mkhrenov/openhell/openhell-pcb/symbols-and-footprints/bnyah_knife.png

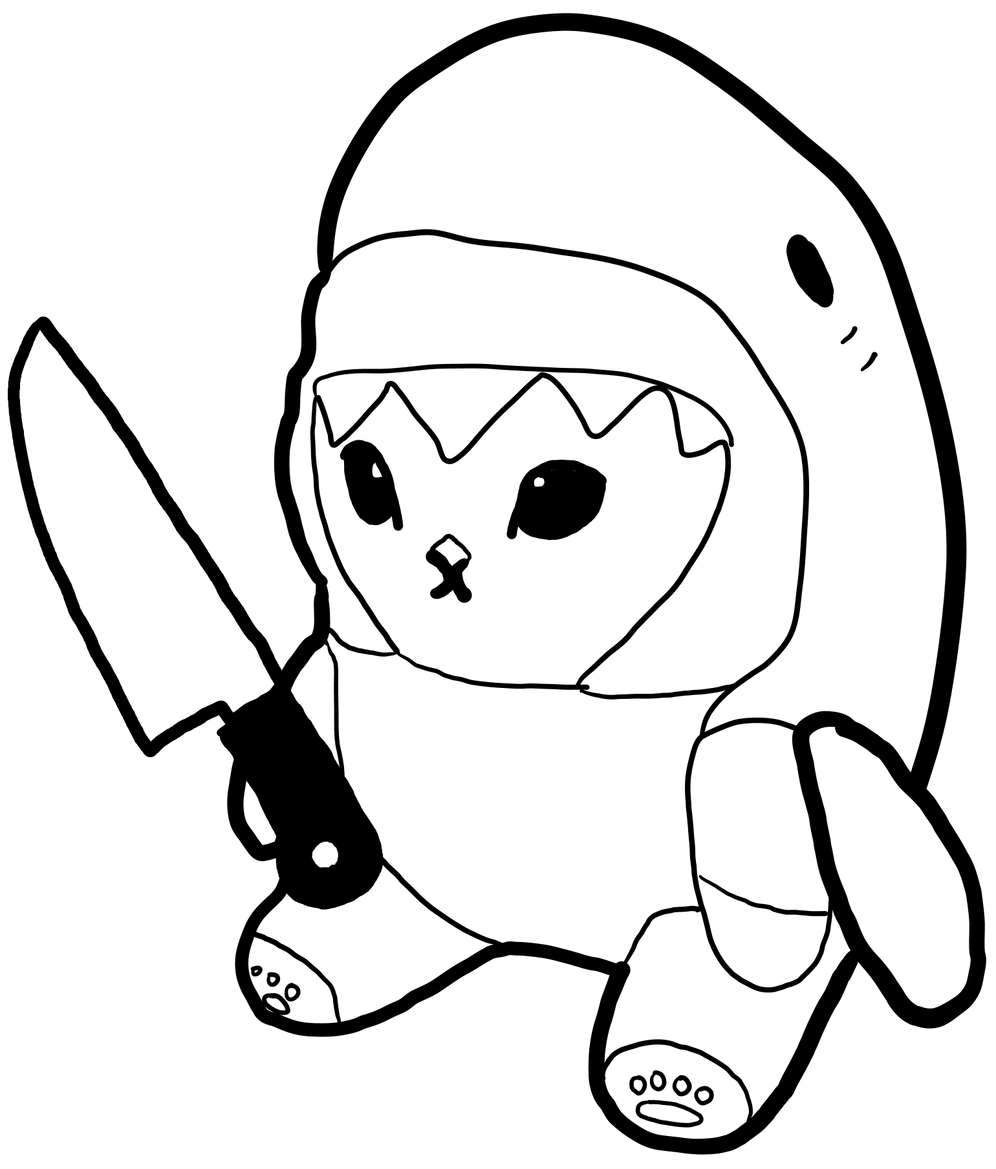
openhell-pcb/symbols-and-footprints/bnyah_knife.png
