mkhrenov/openhell/openhell-pcb/symbols-and-footprints/bnyah_peek.png

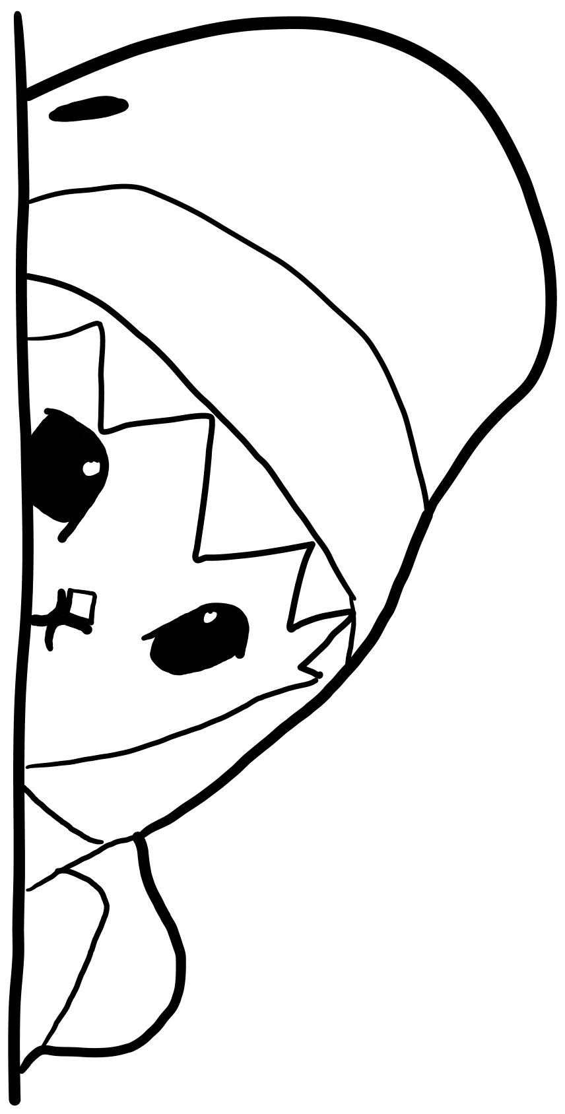
openhell-pcb/symbols-and-footprints/bnyah_peek.png
