mkhrenov/openhell/openhell-pcb/symbols-and-footprints/bnyahaj.png

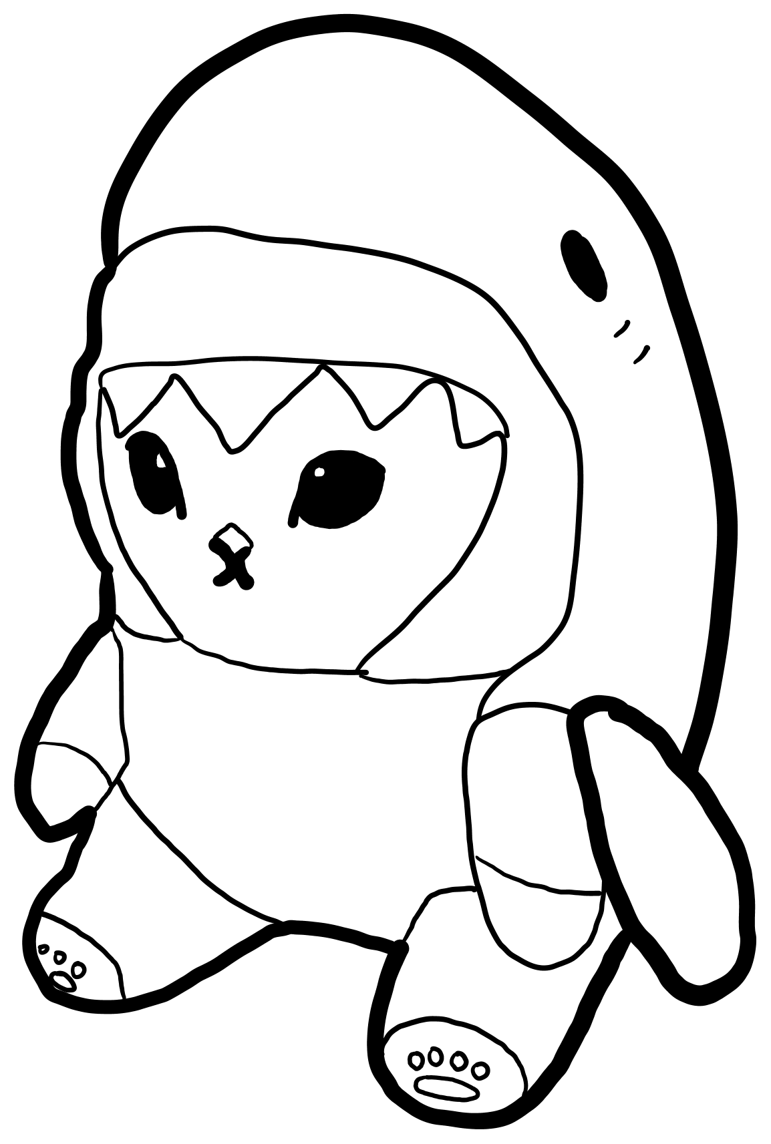
openhell-pcb/symbols-and-footprints/bnyahaj.png
