mkhrenov/openhell/openhell-pcb/symbols-and-footprints/bnyarson.png

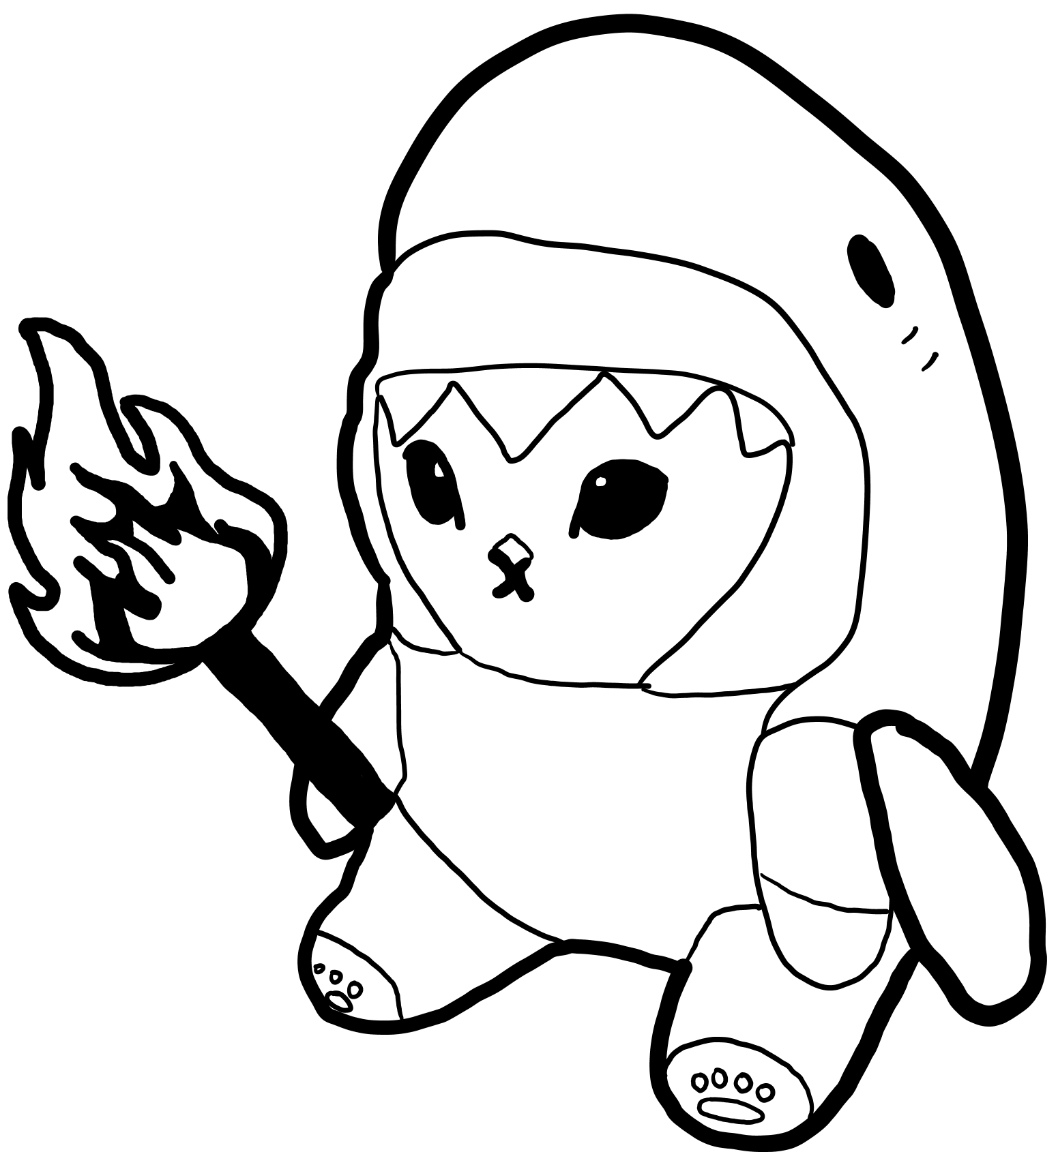
openhell-pcb/symbols-and-footprints/bnyarson.png
