mkhrenov/openhell/openhell-pcb/symbols-and-footprints/bnyarson_flipped.png

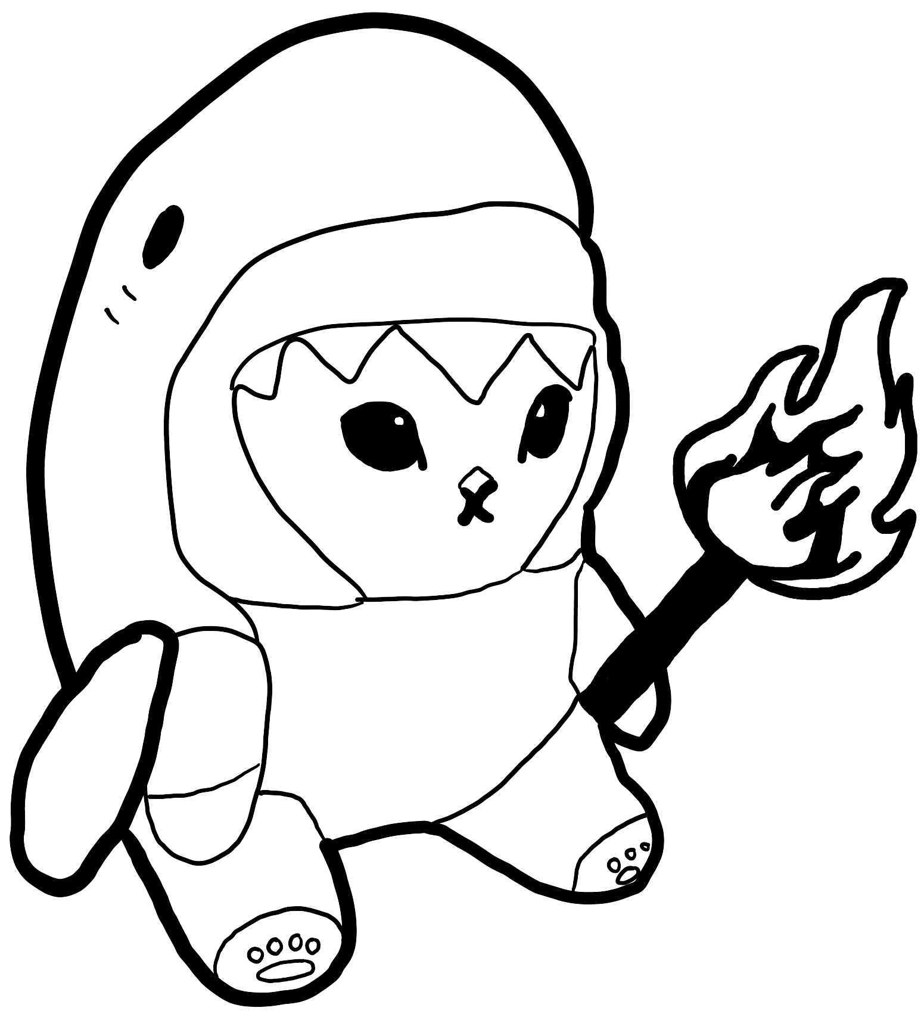
openhell-pcb/symbols-and-footprints/bnyarson_flipped.png
