mkhrenov/openhell/openhell-pcb/symbols-and-footprints/pittsburgh.jpg

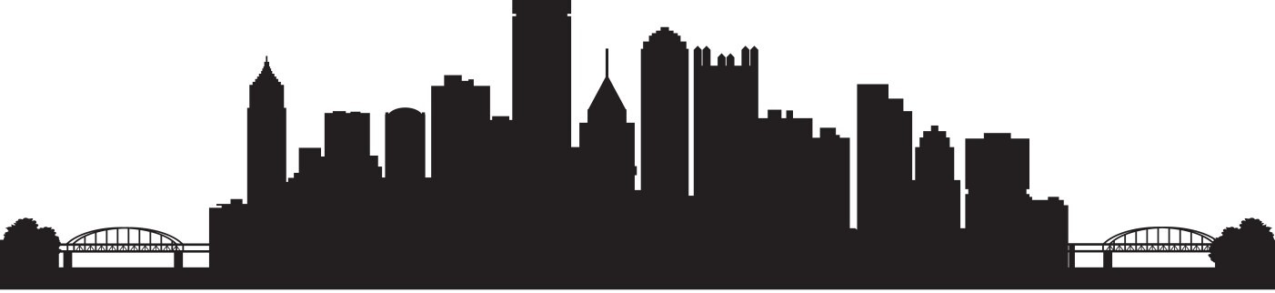
openhell-pcb/symbols-and-footprints/pittsburgh.jpg
