mkhrenov/openhell/openhell-pcb/symbols-and-footprints/steel_mill.png

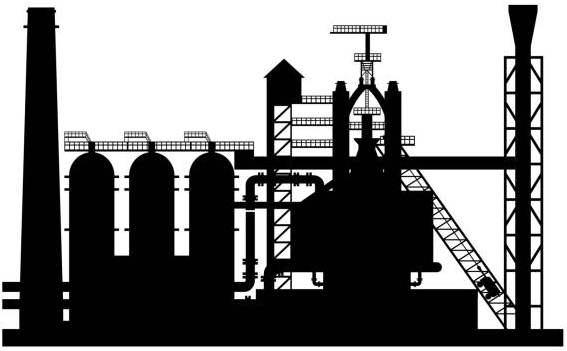
openhell-pcb/symbols-and-footprints/steel_mill.png
