mkhrenov/openhell/openhell-pcb/Mouser-BOM.xls

SHOPPING CART
This is not an invoice
10-Mar-25 10:58:04
 | Mouser # | Mfr. # | Manufacturer | Customer # | Description | RoHS | Lifecycle | Order Qty. | Price (USD) | Ext.: (USD)
1 | 511-LSM6DSRTR | LSM6DSRTR | STMicroelectronics |  | IMUs - Inertial Measurement Units iNEMO Inertial Module: 3D Accelerometer and 3D Gyroscope | RoHS Compliant |  | 1 | $3.58 | $3.58
2 | 55-IF145-060-3 | IF145-060-3 | iFixit |  | Pliers & Tweezers Precision Tweezer Set | Not Applicable | New Product | 1 | $9.95 | $9.95
3 | 621-AP63205WU-7 | AP63205WU-7 | Diodes Incorporated |  | Switching Voltage Regulators DCDC Conv HV Buck TSOT26 T&R 3K | RoHS Compliant |  | 1 | $1.38 | $1.38
4 | 511-H3LIS331DLTR | H3LIS331DLTR | STMicroelectronics |  | Accelerometers Low Pwr Hi G 3-axis Digital Acceleromtr | RoHS Compliant By Exemption |  | 1 | $9.76 | $9.76
5 | 710-691137710002 | 691137710002 | Wurth Elektronik | Screw Terminals | Barrier Terminal Blocks WR-TBL 300VAC 16A 2P Right Angle | RoHS Compliant |  | 1 | $0.41 | $0.41
6 | 187-CL21A106KOQNNNG | CL21A106KOQNNNG | Samsung Electro-Mechanics | C8 | Multilayer Ceramic Capacitors MLCC - SMD/SMT 10uF+/-10% 16V X5R 2 0805 | RoHS Compliant |  | 1 | $0.10 | $0.10
7 | 187-CL05B104KP5NNNC | CL05B104KP5NNNC | Samsung Electro-Mechanics | C5, C6, C7 | Multilayer Ceramic Capacitors MLCC - SMD/SMT 100nF+/-10% 10V X7R 0402 | RoHS Compliant |  | 3 | $0.10 | $0.30
8 | 187-CL10A226MP8NUNE | CL10A226MP8NUNE | Samsung Electro-Mechanics | C3, C4 | Multilayer Ceramic Capacitors MLCC - SMD/SMT 22uF+/-20% 10V X5R 1 0603 | RoHS Compliant |  | 2 | $0.13 | $0.26
9 | 81-GRM188R6YA106MA3D | GRM188R6YA106MA73D | Murata | C1 | Multilayer Ceramic Capacitors MLCC - SMD/SMT 10 uF 35 VDC 20% 0603 X5R | RoHS Compliant |  | 1 | $0.30 | $0.30
10 | 815-ASPI-4030S-4R7MT | ASPI-4030S-4R7M-T | ABRACON | L1 | Power Inductors - SMD 4.7 UH 20% | RoHS Compliant By Exemption |  | 1 | $0.29 | $0.29
11 | 81-GRM33R6YA104KE14D | GRM033R6YA104KE14D | Murata | C2 | Multilayer Ceramic Capacitors MLCC - SMD/SMT 0.1 uF 35 VDC 10% 0201 X5R | RoHS Compliant |  | 1 | $0.13 | $0.13
12 | 200-TSW10608TTRA | TSW-106-08-T-T-RA | Samtec | GPIO Headers | Headers & Wire Housings Classic PCB Header Strips, 0.100" pitch | RoHS Compliant |  | 1 | $1.34 | $1.34
By submitting your order you agree to these terms and conditions. (https://www.mouser.com/saleterms) |  |  |  |  |  |  |  |  | Merchandise: | $27.80
Prices are reflected at the date and time shown. |  |  |  |  |  |  |  |  | Shipping Charge: | $4.99
