mkhrenov/openhell/openhell-pcb/Pinout.xlsx

Arduino Pin Label | GPIO Number | Connection
D2 | 5 | RP2 RX (Arduino TX)
D3 | 6 | RP2 TX (Arduino RX)
D13 | 16 | SPI SCK
D12 | 47 | SPI CIPO
D11 | 38 | SPI COPI
D10 | 21 | SPI CS0 (LSM6DSRTR)
D9 | 18 | SPI CS1 (H3LIS331DLTR)
