mkhrenov/openhell/0000 - OPENHELL CAD/1000 - STRUCTURE/P-1005-F - TOP WEAPON LOCK V2.SLDPRT

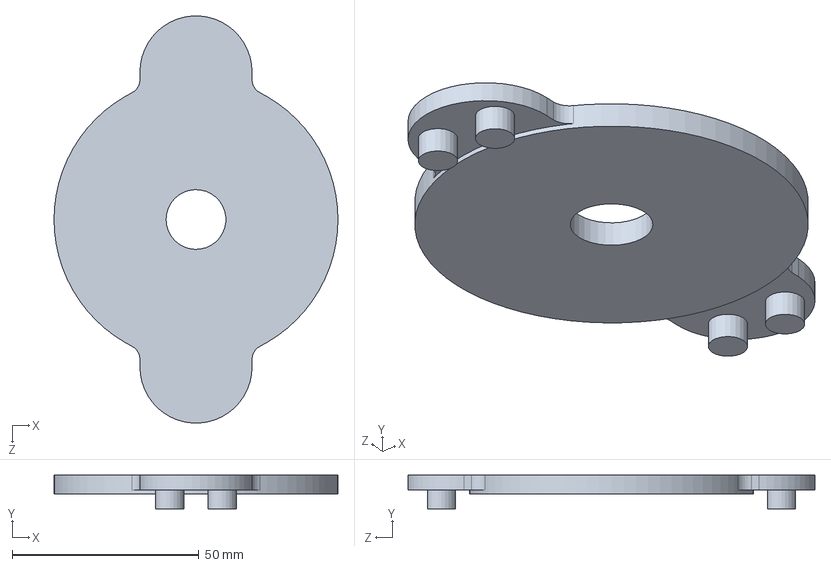
[picture p8: CAD file, 2025-04-30]
0000 - OPENHELL CAD/1000 - STRUCTURE/P-1005-F - TOP WEAPON LOCK V2.SLDPRT
76.0 x 9.00 x 108.9 mm
