mkhrenov/openhell/0000 - OPENHELL CAD/3000 - ELECTRONICS/P-3003-P - XT60E-F PLUG.SLDPRT

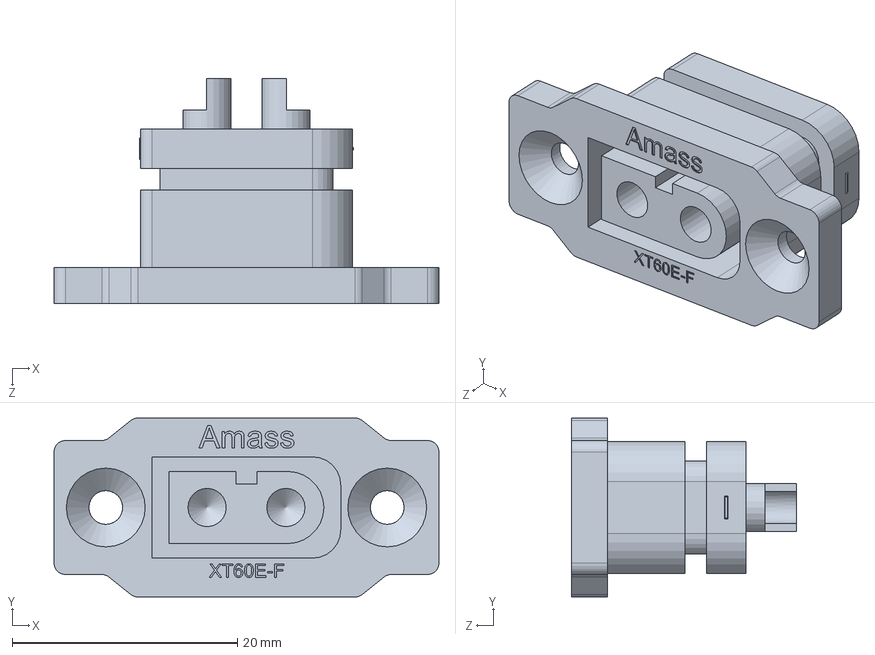
[picture p9: CAD file, 2025-04-19]
0000 - OPENHELL CAD/3000 - ELECTRONICS/P-3003-P - XT60E-F PLUG.SLDPRT
34.2 x 15.9 x 20.0 mm
