mkhrenov/openhell/0000 - OPENHELL CAD/4000 - INSTRUMENTATION/EDF LOAD CELL MOUNT.SLDPRT

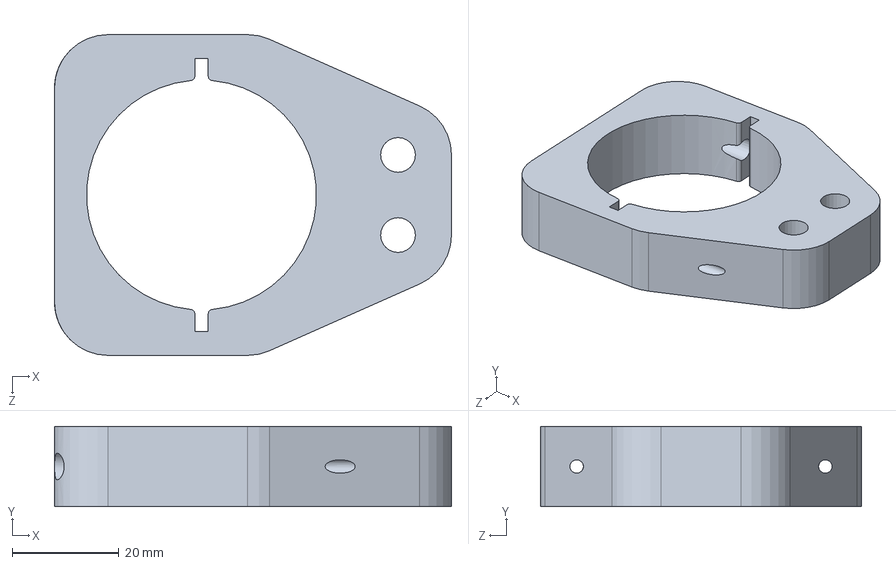
[picture p10: CAD file, 2025-04-08]
0000 - OPENHELL CAD/4000 - INSTRUMENTATION/EDF LOAD CELL MOUNT.SLDPRT
74.2 x 15.0 x 60.0 mm
