mkhrenov/openhell/3d print/P-1006-F - SERVICE CAP.STEP

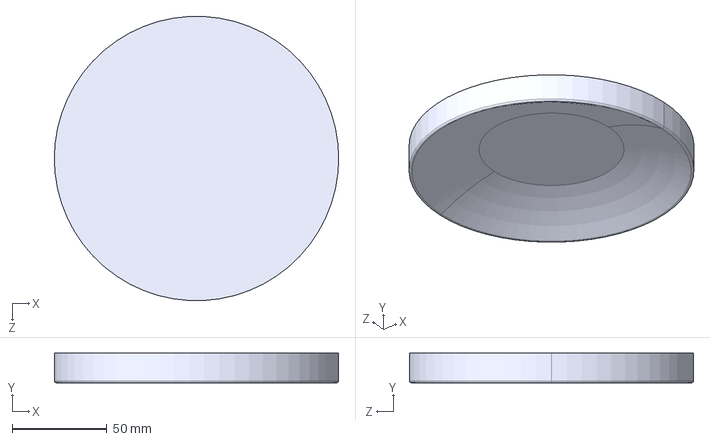
[picture p11: CAD file, 2025-04-30]
3d print/P-1006-F - SERVICE CAP.STEP
150.3 x 15.6 x 150.1 mm
