mkhrenov/openhell/openhell-pcb/combat-pcb.step

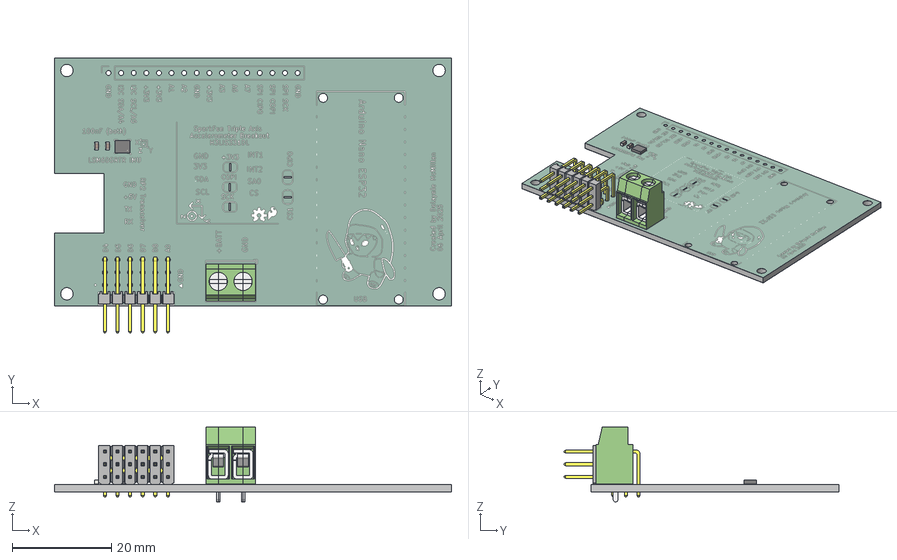
[picture p12: CAD file, 2025-05-05]
openhell-pcb/combat-pcb.step
80.0 x 55.4 x 15.1 mm
LGA-14_3x2.5mm_P0.5mm_LayoutBorder3x4y
TSW-106-08-T-T-RA_body
T-1S6-08-TSW-1-08-6-RA-T
MRT12P5_SX
MRT12P5_CNT
MRT12P5_DX
C_0603_1608Metric x 2
combat-pcb_silkscreen
combat-pcb_soldermask
combat-pcb_PCB
