mkhrenov/openhell/0000 - OPENHELL CAD/1000 - STRUCTURE/P-1004-P - HAT V2.SLDPRT

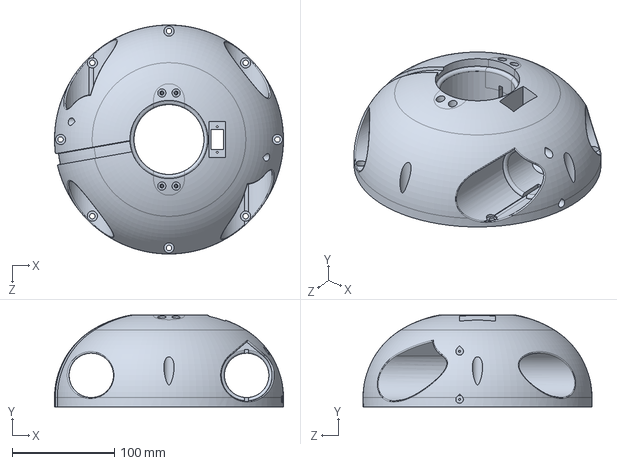
[picture p13: CAD file, 2025-04-30]
0000 - OPENHELL CAD/1000 - STRUCTURE/P-1004-P - HAT V2.SLDPRT
224.0 x 89.5 x 224.0 mm
