mkhrenov/openhell/0000 - OPENHELL CAD/2000 - FASTENERS/P-2001-P - M5 FLANGED LOCKNUT 92461A200.SLDPRT

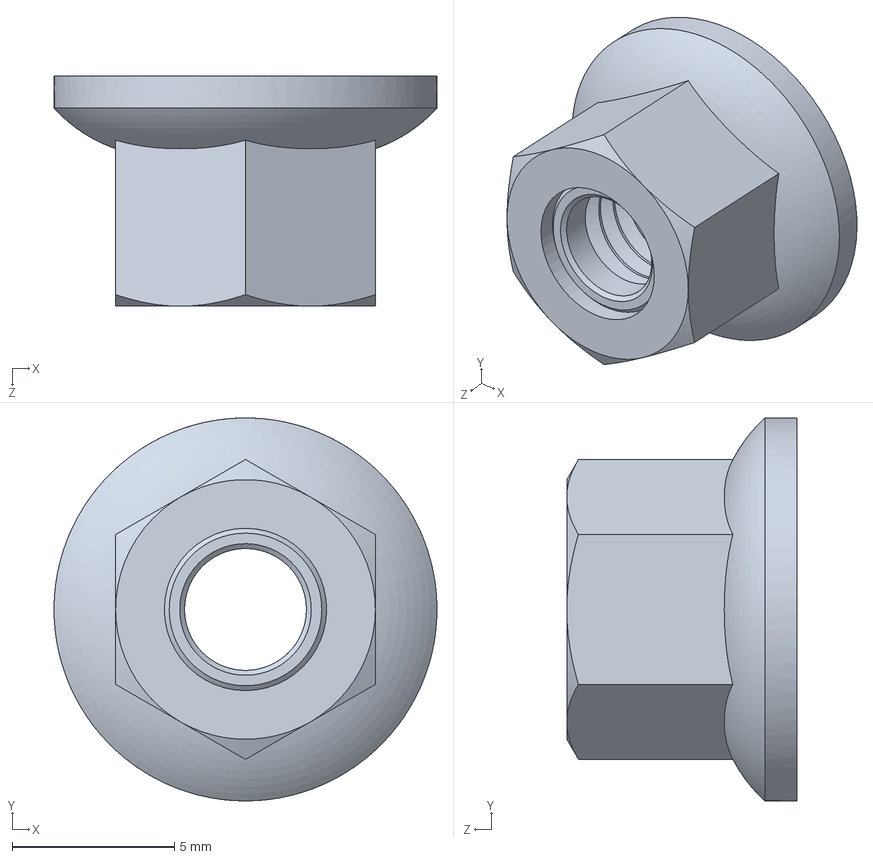
[picture p14: CAD file, 2025-04-19]
0000 - OPENHELL CAD/2000 - FASTENERS/P-2001-P - M5 FLANGED LOCKNUT 92461A200.SLDPRT
11.8 x 11.8 x 7.10 mm
