mkhrenov/openhell/3d print/P-1003-P - BRIM.STEP

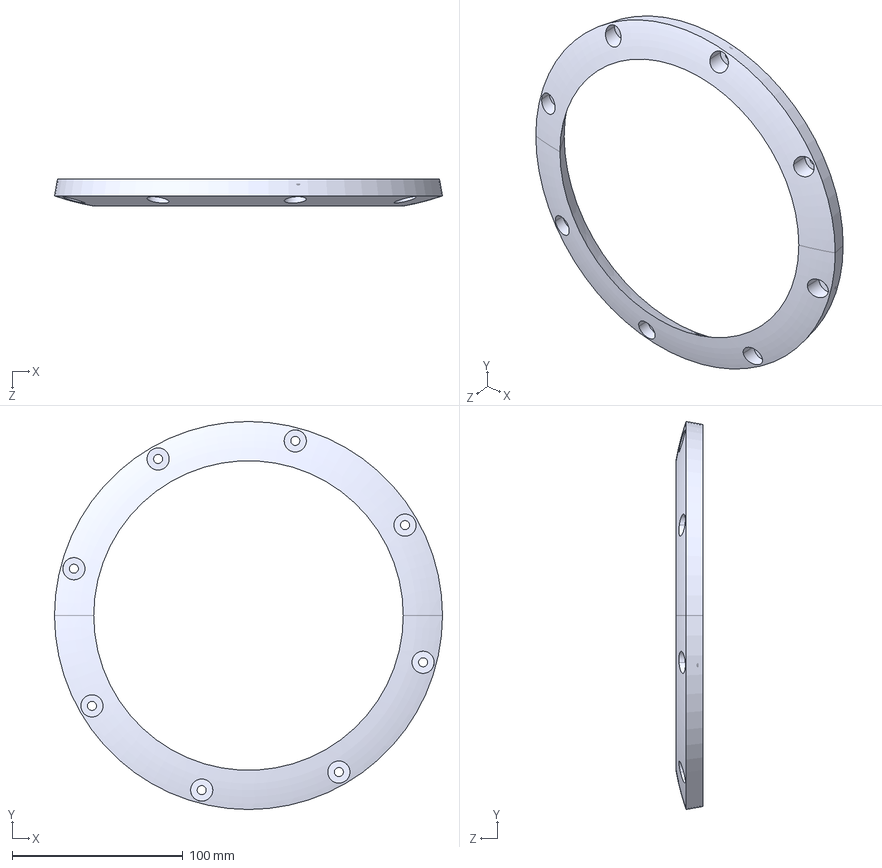
[picture p15: CAD file, 2025-04-08]
3d print/P-1003-P - BRIM.STEP
227.5 x 227.5 x 16.0 mm
