mkhrenov/openhell/0000 - OPENHELL CAD/1000 - STRUCTURE/S-1005-F - TOP WEAPON LOCK.3MF

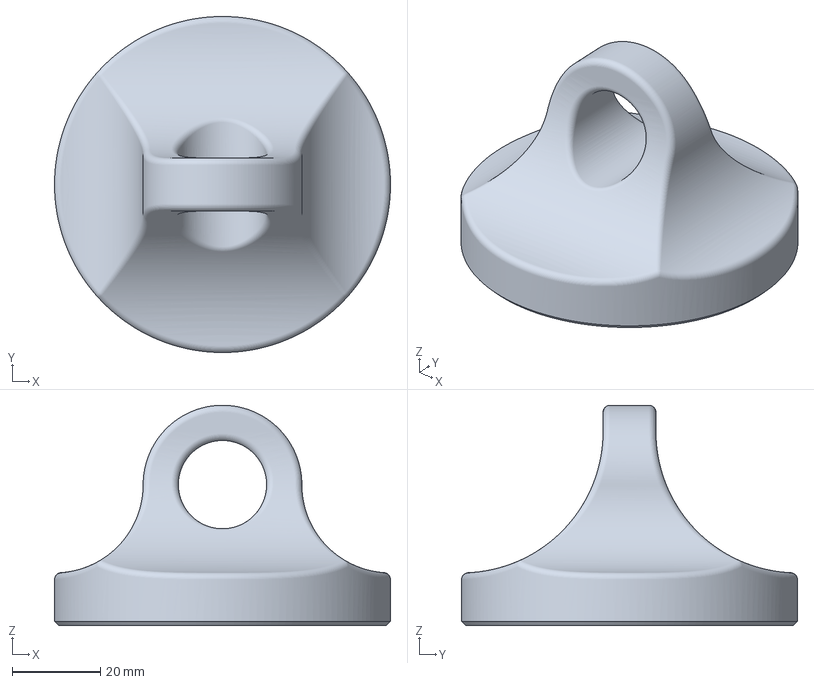
[picture p16: CAD file, 2025-04-19]
0000 - OPENHELL CAD/1000 - STRUCTURE/S-1005-F - TOP WEAPON LOCK.3MF
76.2 x 76.2 x 50.0 mm
