mkhrenov/openhell/3d print/P-1001-M - PLATE.DXF

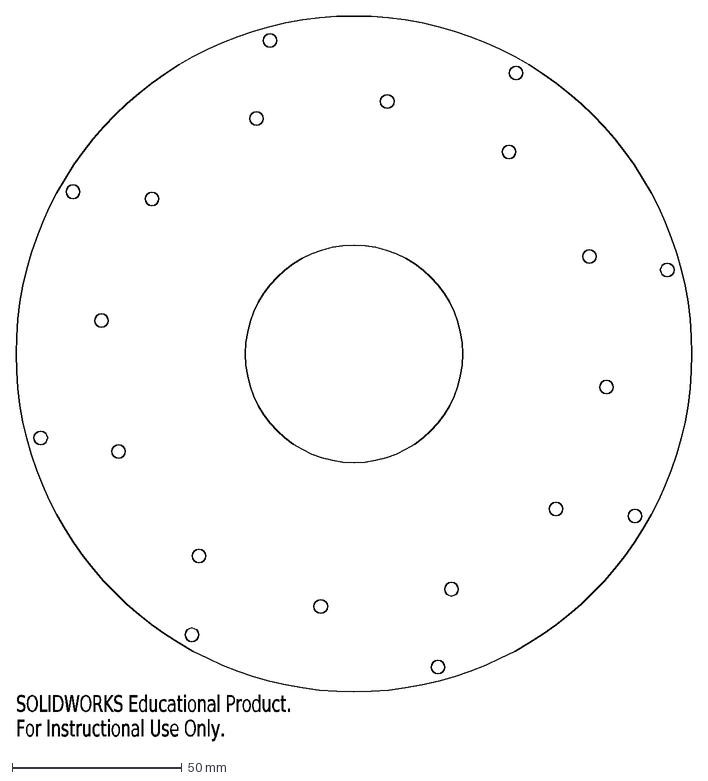
[picture p17: CAD file, 2025-04-08]
3d print/P-1001-M - PLATE.DXF
SOLIDWORKS Educational Product.
For Instructional Use Only.
