mkhrenov/openhell/0000 - OPENHELL CAD/1000 - STRUCTURE/P-1001-M - PLATE.SLDPRT

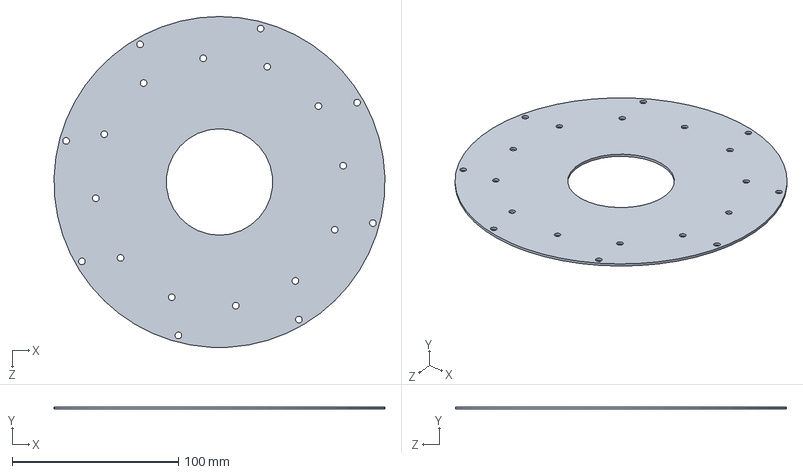
[picture p18: CAD file, 2025-04-19]
0000 - OPENHELL CAD/1000 - STRUCTURE/P-1001-M - PLATE.SLDPRT
198.9 x 1.50 x 199.0 mm
