mkhrenov/openhell/3d print/P-1005-P - SPREADER.STEP

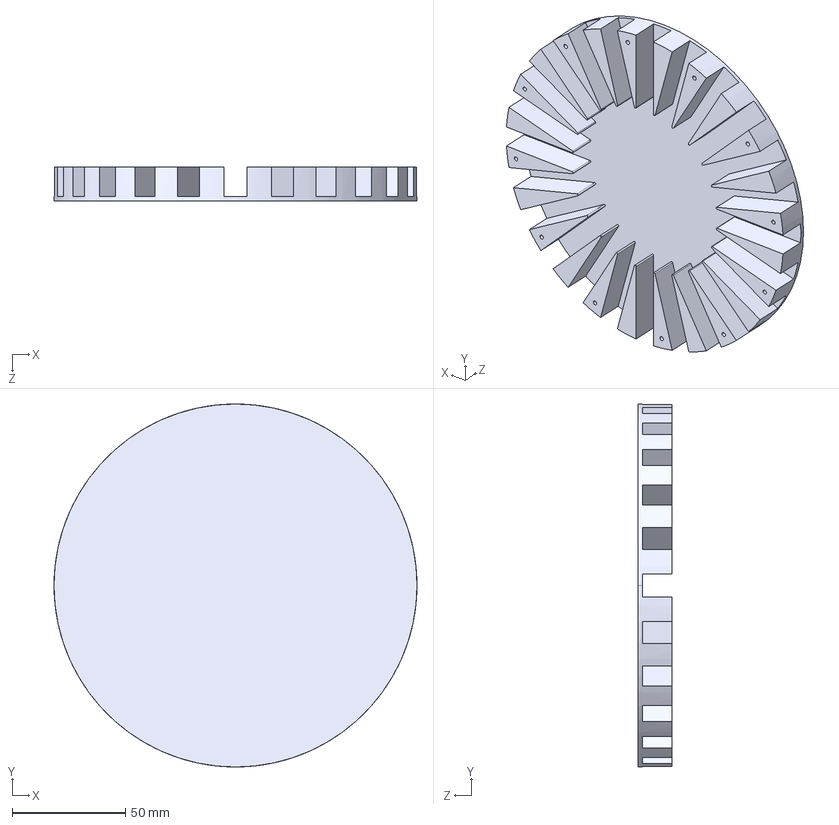
[picture p19: CAD file, 2025-04-08]
3d print/P-1005-P - SPREADER.STEP
160.0 x 160.0 x 15.0 mm
