mkhrenov/openhell/0000 - OPENHELL CAD/3000 - ELECTRONICS/P-3002-P - 4S 2000 mAh BATTERY.SLDPRT

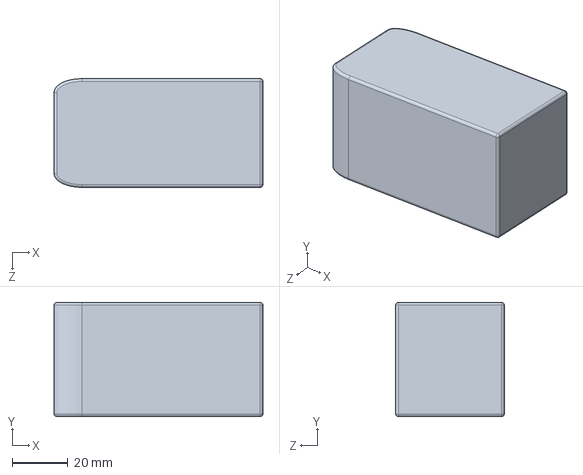
[picture p20: CAD file, 2025-04-19]
0000 - OPENHELL CAD/3000 - ELECTRONICS/P-3002-P - 4S 2000 mAh BATTERY.SLDPRT
75.0 x 41.0 x 39.0 mm
