mkhrenov/openhell/0000 - OPENHELL CAD/1000 - STRUCTURE/S-1004-F - SIDE WEAPON LOCK.3MF

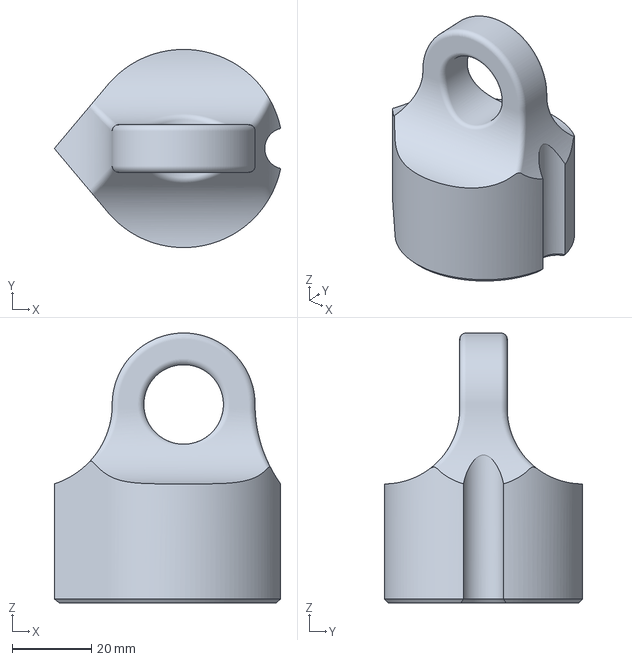
[picture p21: CAD file, 2025-04-19]
0000 - OPENHELL CAD/1000 - STRUCTURE/S-1004-F - SIDE WEAPON LOCK.3MF
57.0 x 49.9 x 68.0 mm
