mkhrenov/openhell/0000 - OPENHELL CAD/3000 - ELECTRONICS/P-3004-P - 45A ESC.SLDPRT

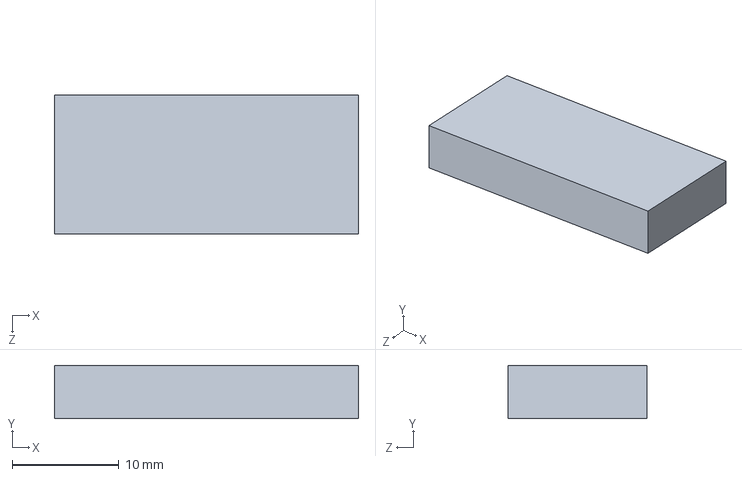
[picture p22: CAD file, 2025-04-19]
0000 - OPENHELL CAD/3000 - ELECTRONICS/P-3004-P - 45A ESC.SLDPRT
28.5 x 5.00 x 13.0 mm
