mkhrenov/openhell/0000 - OPENHELL CAD/3000 - ELECTRONICS/P-3001-P - EDF.SLDPRT

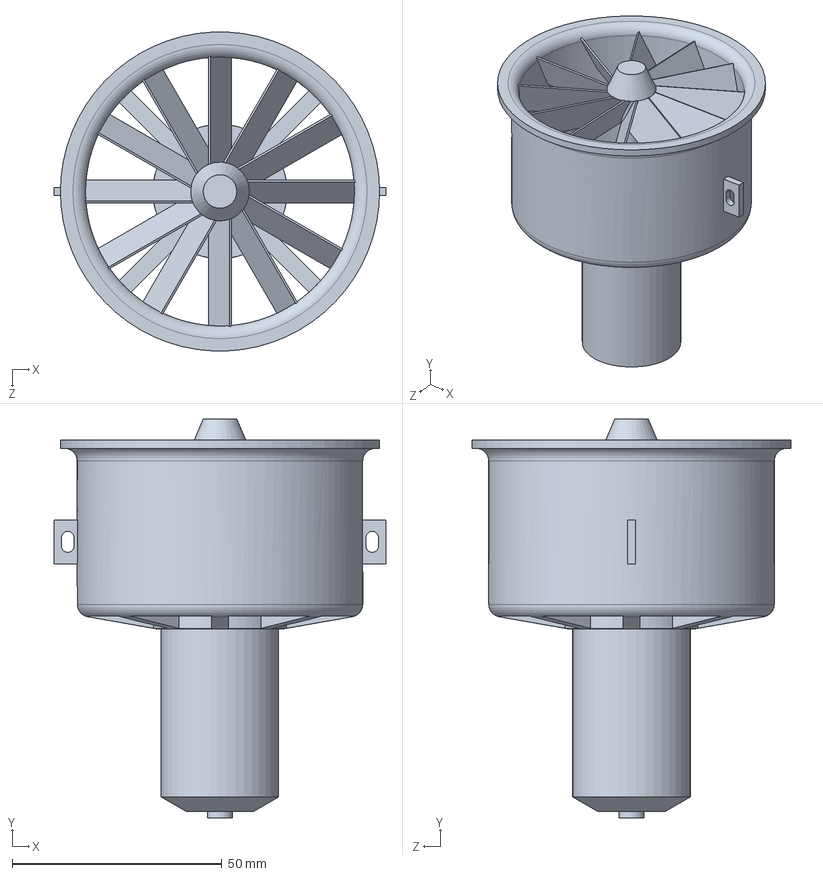
[picture p23: CAD file, 2025-04-19]
0000 - OPENHELL CAD/3000 - ELECTRONICS/P-3001-P - EDF.SLDPRT
79.0 x 95.0 x 75.9 mm
