mkhrenov/openhell/0000 - OPENHELL CAD/1000 - STRUCTURE/P-1002-P - BLADE.SLDPRT

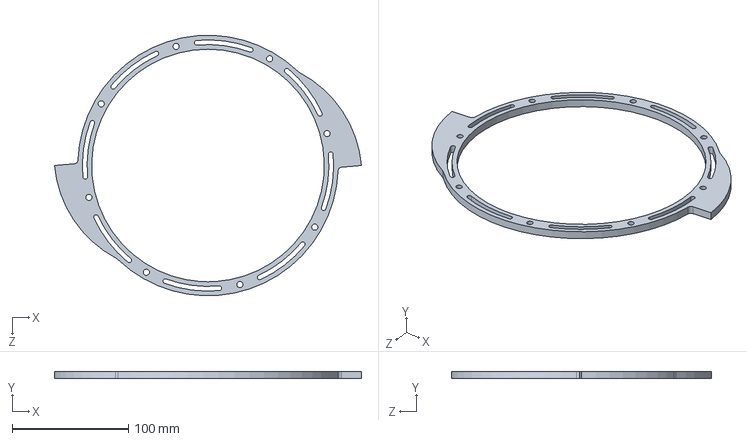
[picture p24: CAD file, 2025-04-19]
0000 - OPENHELL CAD/1000 - STRUCTURE/P-1002-P - BLADE.SLDPRT
264.0 x 6.35 x 223.8 mm
