mkhrenov/openhell/0000 - OPENHELL CAD/3000 - ELECTRONICS/P-3005-P - PROTOBOARD.SLDPRT

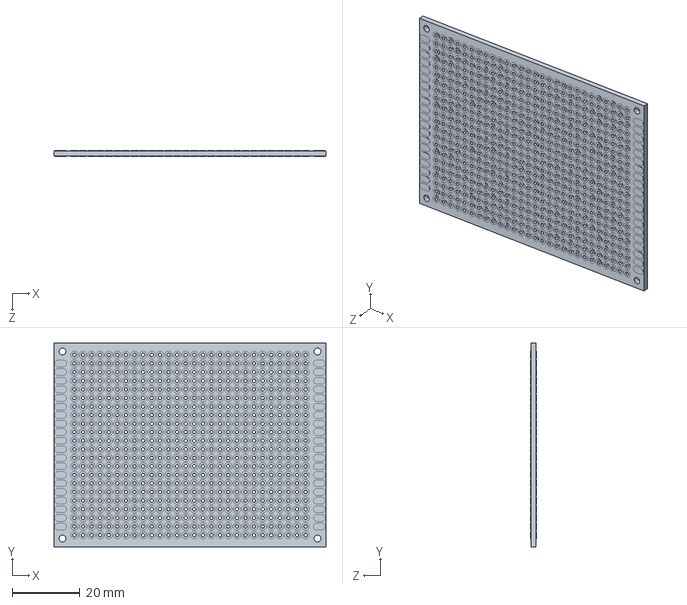
[picture p25: CAD file, 2025-04-08]
0000 - OPENHELL CAD/3000 - ELECTRONICS/P-3005-P - PROTOBOARD.SLDPRT
80.0 x 60.0 x 1.70 mm
