mkhrenov/openhell/0000 - OPENHELL CAD/1000 - STRUCTURE/D-1002-P - BLADE.DXF

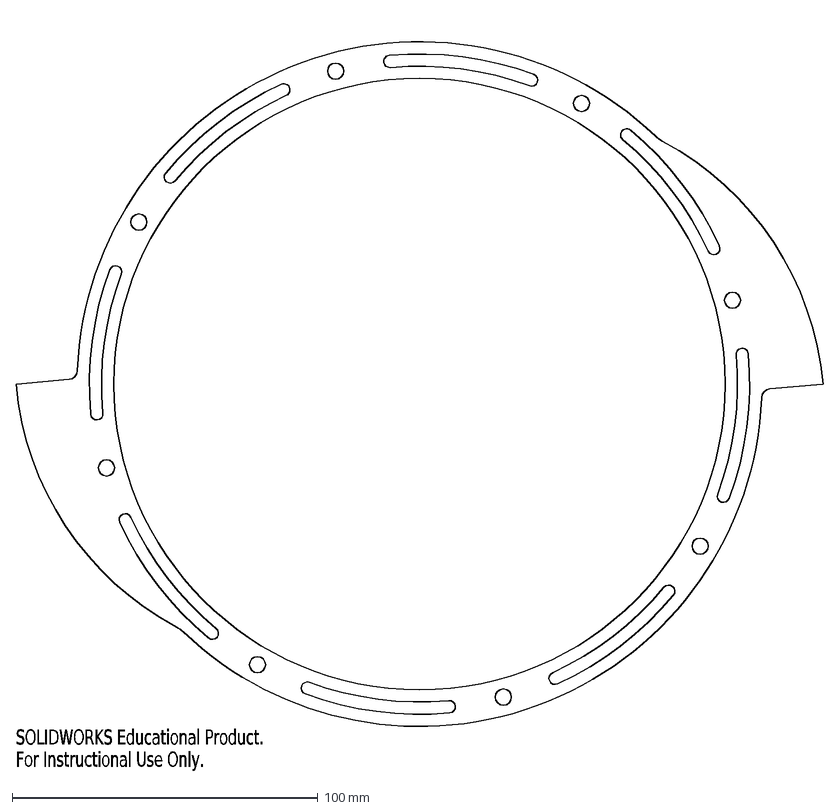
[picture p26: CAD file, 2025-04-08]
0000 - OPENHELL CAD/1000 - STRUCTURE/D-1002-P - BLADE.DXF
SOLIDWORKS Educational Product.
For Instructional Use Only.
