mkhrenov/openhell/0000 - OPENHELL CAD/1000 - STRUCTURE/S-1005-P - SPREADER.3MF

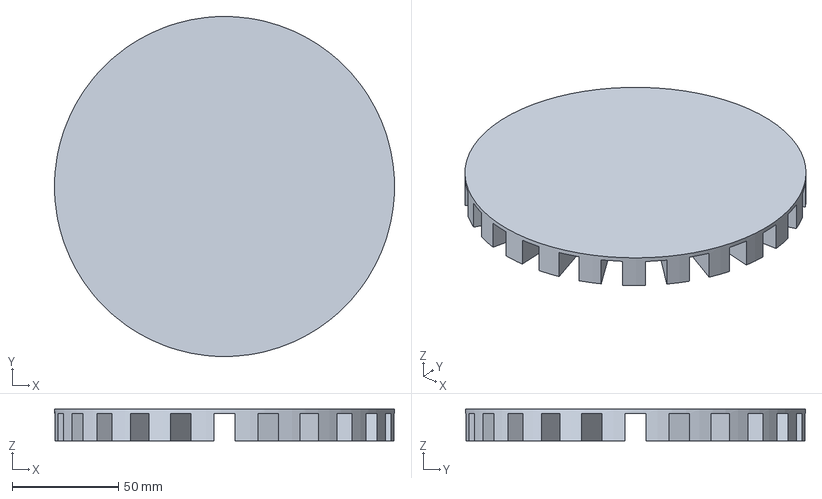
[picture p27: CAD file, 2025-03-09]
0000 - OPENHELL CAD/1000 - STRUCTURE/S-1005-P - SPREADER.3MF
160.0 x 160.0 x 15.0 mm
