mkhrenov/openhell/0000 - OPENHELL CAD/1000 - STRUCTURE/S-1004-P - HAT.3MF

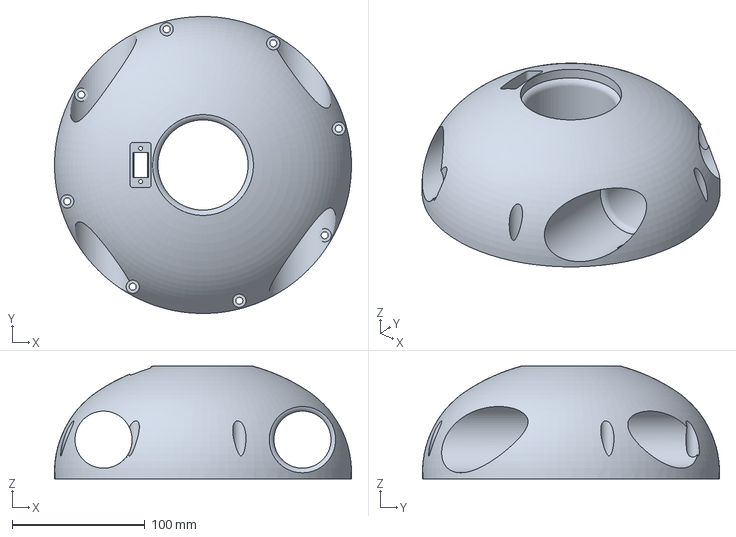
[picture p28: CAD file, 2025-03-09]
0000 - OPENHELL CAD/1000 - STRUCTURE/S-1004-P - HAT.3MF
224.0 x 224.0 x 84.9 mm
