mkhrenov/openhell/0000 - OPENHELL CAD/A-0000-N - HOVERMELT V2.SLDASM

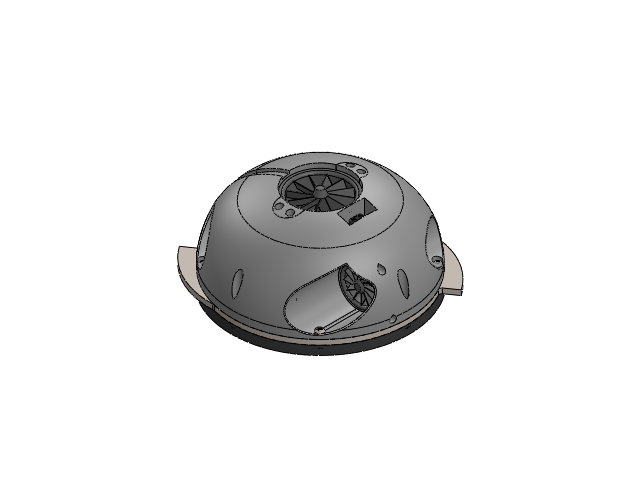
[picture p29: CAD file, 2025-04-30]
0000 - OPENHELL CAD/A-0000-N - HOVERMELT V2.SLDASM
P-1004-P - HAT V2
TSW-106-08-T-T-RA_body_1.step
T-1S6-08-TSW-1-08-6-RA-T_1.step
MRT12P5_SX_1.step
MRT12P5_CNT_1.step
MRT12P5_DX_1.step
LGA-14_3x2.5mm_P0.5mm_LayoutBorder3x4y_1.step
C_0603_1608Metric_1.step x 2
combat-pcb_silkscreen_1.step
combat-pcb_soldermask_1.step
combat-pcb_PCB_1.step
P-3002-P - 4S 2000 mAh BATTERY x 2
P-3001-P - EDF x 3
P-3003-P - XT60E-F PLUG
P-3004-P - 45A ESC x 3
P-1001-M - PLATE
P-1005-P - SPREADER
P-1002-P - BLADE
P-1003-P - BRIM
P-2002-P - M5 20mm BUTTON HEAD SCREW 91306A668 x 8
P-2001-P - M5 FLANGED LOCKNUT 92461A200 x 8
P-2003-P - No. 6 0.375in TORX PLASTITE SCREW 99512A665 x 28
