mkhrenov/openhell/0000 - OPENHELL CAD/3000 - ELECTRONICS/P-3010-P - XT60H Male Connector.SLDASM

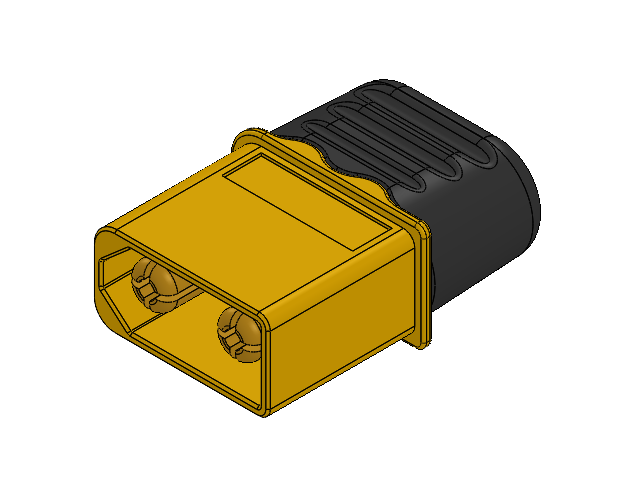
[picture p30: CAD file, 2025-04-19]
0000 - OPENHELL CAD/3000 - ELECTRONICS/P-3010-P - XT60H Male Connector.SLDASM
