mkhrenov/openhell/(list of files, cad)

Other CAD files:
0000 - OPENHELL CAD/3000 - ELECTRONICS/Body004.SLDPRT
3d print/P-1004-P - HAT V2.STEP
0000 - OPENHELL CAD/1000 - STRUCTURE/P-1006-F - SERVICE CAP.SLDPRT
0000 - OPENHELL CAD/3000 - ELECTRONICS/Body.SLDPRT
0000 - OPENHELL CAD/3000 - ELECTRONICS/Body001.SLDPRT
0000 - OPENHELL CAD/3000 - ELECTRONICS/Body005.SLDPRT
0000 - OPENHELL CAD/1000 - STRUCTURE/P-1004-F - SIDE WEAPON LOCK.SLDPRT
0000 - OPENHELL CAD/1000 - STRUCTURE/P-1003-P - BRIM.SLDPRT
0000 - OPENHELL CAD/1000 - STRUCTURE/P-1005-P - SPREADER.SLDPRT
0000 - OPENHELL CAD/1000 - STRUCTURE/S-1003-P - BRIM.3MF
0000 - OPENHELL CAD/1000 - STRUCTURE/P-1004-P - HAT.SLDPRT
0000 - OPENHELL CAD/1000 - STRUCTURE/P-1005-F - TOP WEAPON LOCK.SLDPRT
0000 - OPENHELL CAD/2000 - FASTENERS/P-2002-P - M5 20mm BUTTON HEAD SCREW 91306A668.SLDPRT
0000 - OPENHELL CAD/2000 - FASTENERS/P-2003-P - No. 6 0.375in TORX PLASTITE SCREW 99512A665.SLDPRT
0000 - OPENHELL CAD/4000 - INSTRUMENTATION/EDF LOAD CELL MOUNT.3MF
0000 - OPENHELL CAD/A-0000-N - HOVERMELT.SLDASM
3d print/P-1004-P - HAT.STEP
combat-pcb/combat-pcb.step
openhell-pcb/symbols-and-footprints/Screw_Terminal_01x02.stp
