mkhrenov/openhell/openhell-pcb/combat-pcb.kicad_pcb

## KiCad design openhell-pcb/combat-pcb.kicad_pcb (2025-05-05)

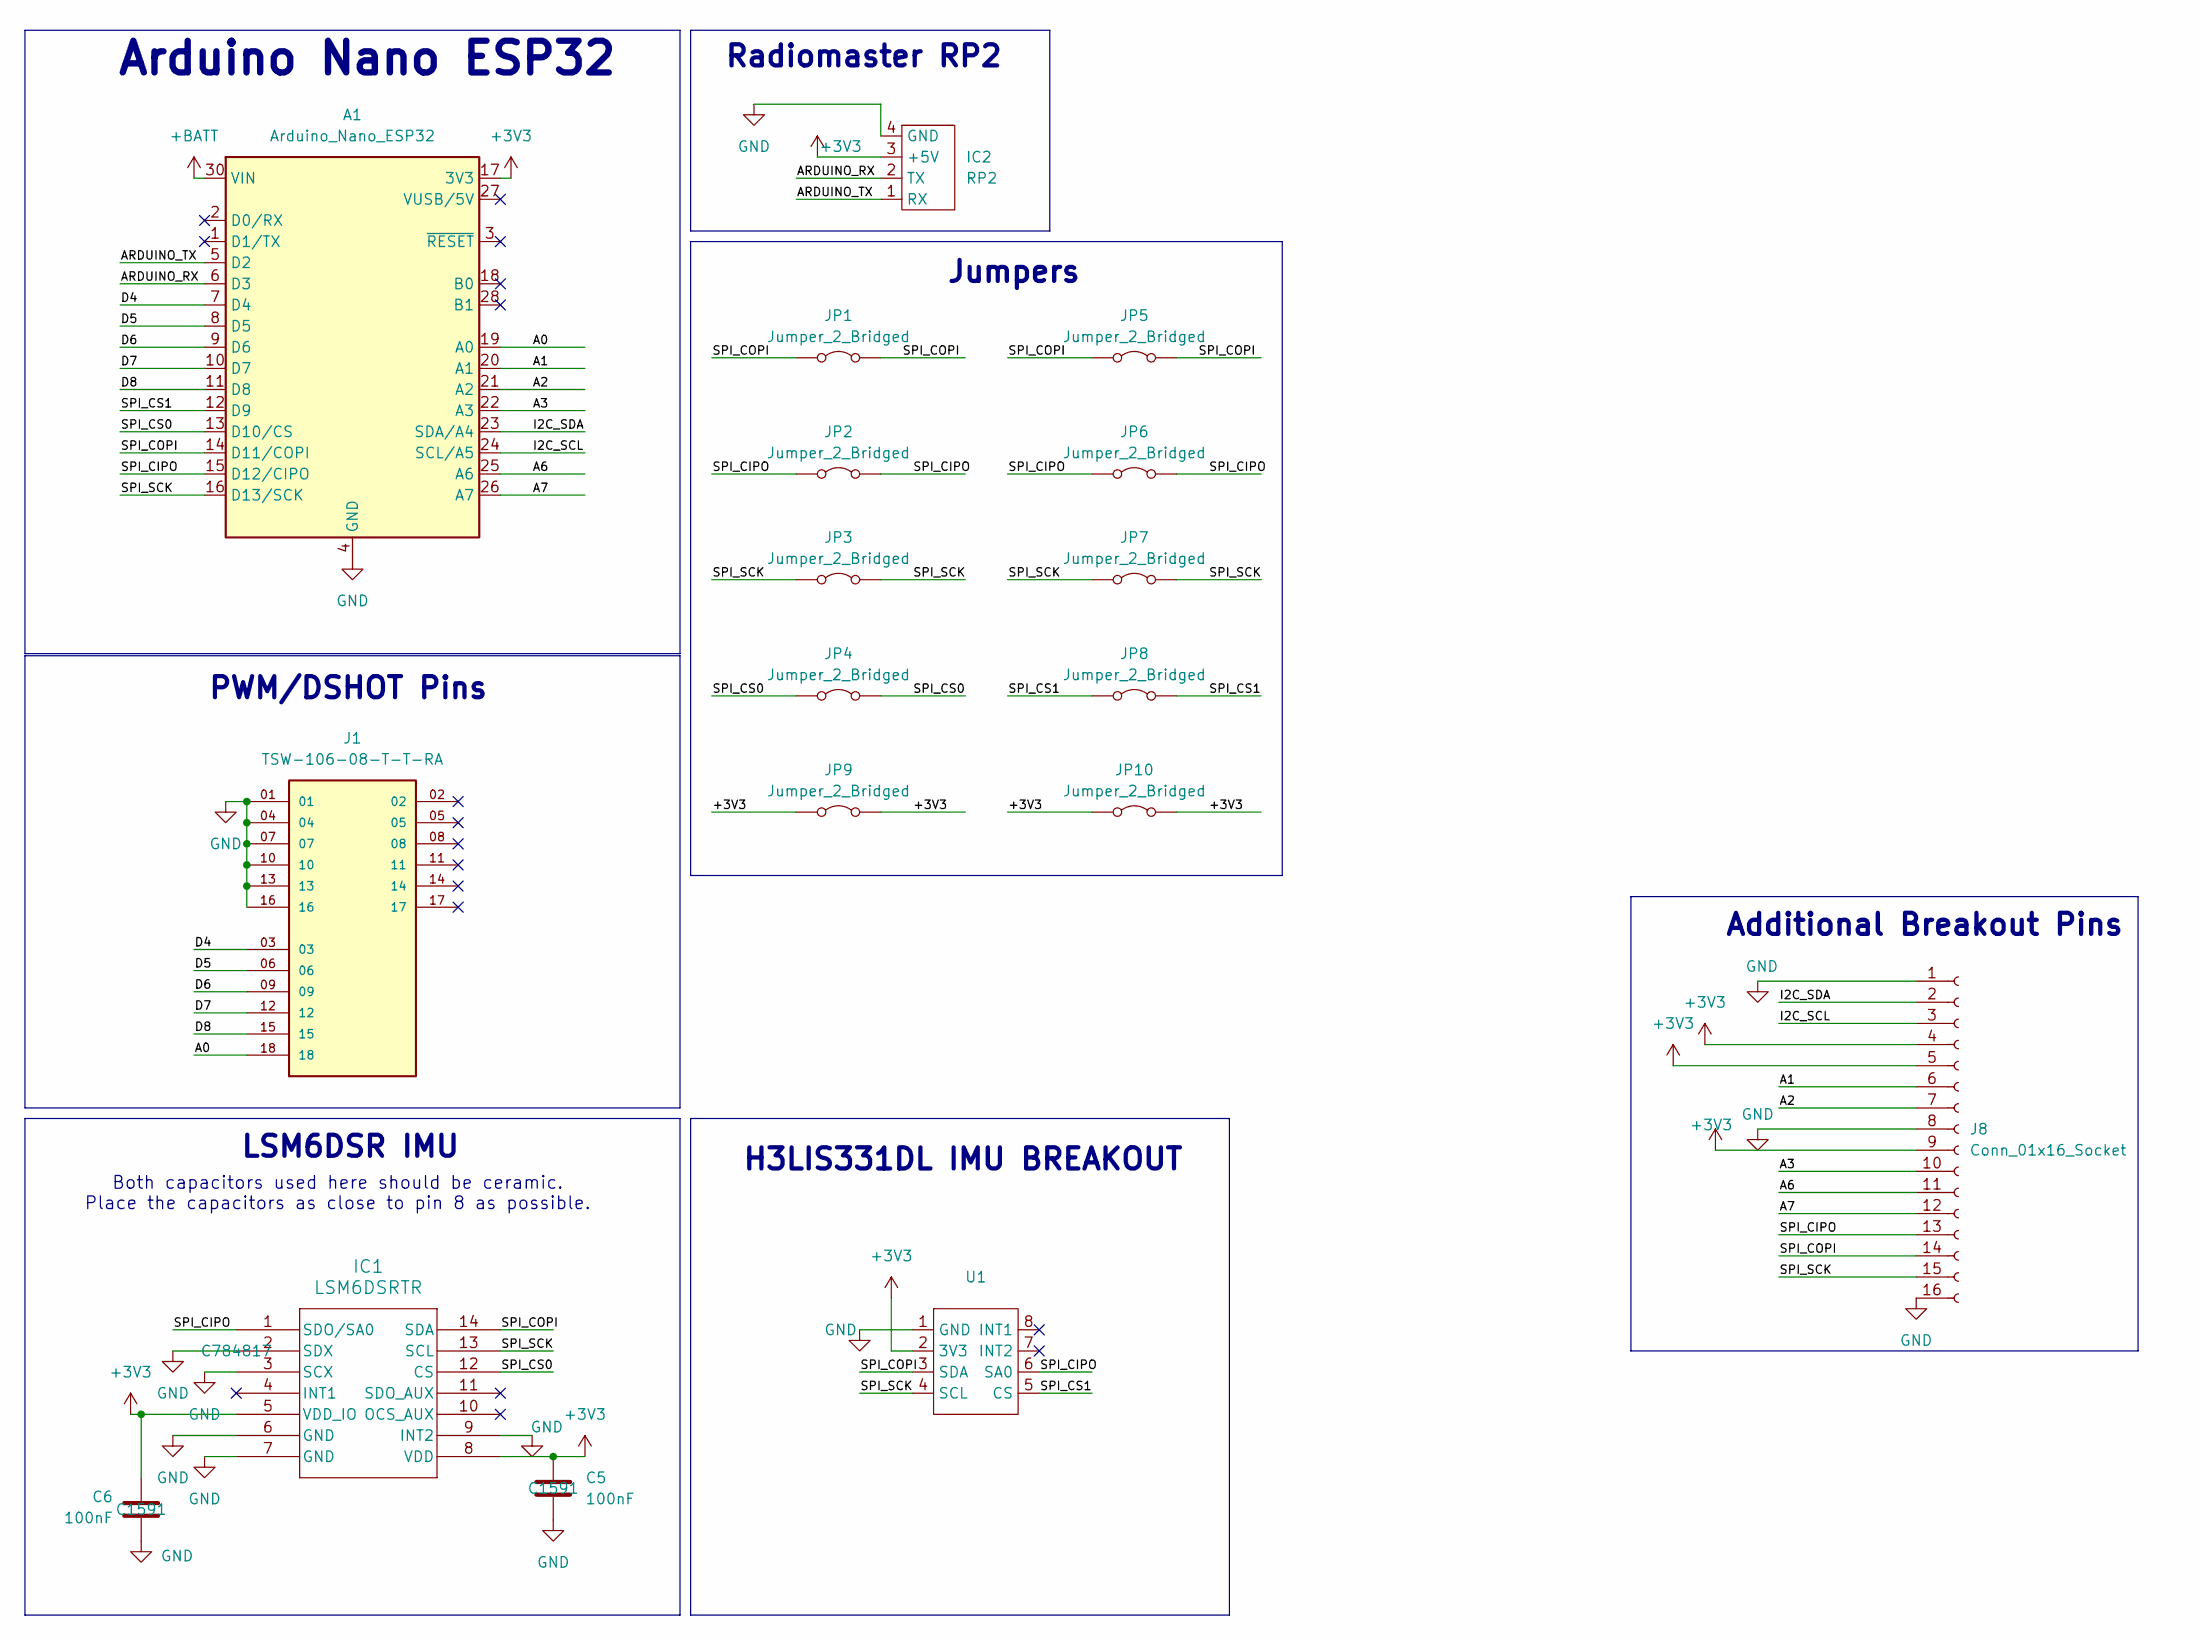
[picture p31: schematic combat-pcb.kicad_sch]

Parts:
A1: Arduino_Nano_ESP32; Arduino_Nano_ESP32_Tile
C5, C6: 100nF; C_0603_1608Metric; LCSC C1591
IC1: LSM6DSRTR; LGA-14_3x2.5mm_P0.5mm_LayoutBorder3x4y; LCSC C784817
IC2: RP2
J1: TSW-106-08-T-T-RA; SAMTEC_TSW-106-08-T-T-RA; PARTREV R
J8: Conn_01x16_Socket; PinSocket_1x16_P2.54mm_Vertical
JP1, JP2, JP3, JP4, JP5, JP6, JP7, JP8, JP9, JP10: Jumper_2_Bridged; SolderJumper-2_P1.3mm_Bridged_RoundedPad1.0x1.5mm
U1: H3LIS331DL-Breakout

Connections:
+3V3: A1.17 (3V3), C5.1, C6.1, IC1.5 (VDD_IO), IC1.8 (VDD), IC2.3 (+5V), J8.4, J8.5, J8.9, JP9.1 (A), JP9.2 (B), JP10.1 (A), JP10.2 (B), U1.2 (3V3)
+BATT: A1.30 (VIN); also elsewhere on the board
/A0: A1.19 (A0), J1.18
/A1: A1.20 (A1), J8.6
/A2: A1.21 (A2), J8.7
/A3: A1.22 (A3), J8.10
/A6: A1.25 (A6), J8.11
/A7: A1.26 (A7), J8.12
/ARDUINO_RX: A1.6 (D3), IC2.2 (TX)
/ARDUINO_TX: A1.5 (D2), IC2.1 (RX)
/D4: A1.7 (D4), J1.03
/D5: A1.8 (D5), J1.06
/D6: A1.9 (D6), J1.09
/D7: A1.10 (D7), J1.12
/D8: A1.11 (D8), J1.15
/I2C_SCL: A1.24 (SCL/A5), J8.3
/I2C_SDA: A1.23 (SDA/A4), J8.2
/SPI_CIPO: A1.15 (D12/CIPO), IC1.1 (SDO/SA0), J8.13, JP2.1 (A), JP2.2 (B), JP6.1 (A), JP6.2 (B), U1.6 (SA0)
/SPI_COPI: A1.14 (D11/COPI), IC1.14 (SDA), J8.14, JP1.1 (A), JP1.2 (B), JP5.1 (A), JP5.2 (B), U1.3 (SDA)
/SPI_CS0: A1.13 (D10/CS), IC1.12 (CS), JP4.1 (A), JP4.2 (B)
/SPI_CS1: A1.12 (D9), JP8.1 (A), JP8.2 (B), U1.5 (CS)
/SPI_SCK: A1.16 (D13/SCK), IC1.13 (SCL), J8.15, JP3.1 (A), JP3.2 (B), JP7.1 (A), JP7.2 (B), U1.4 (SCL)
GND: A1.4 (GND), A1.29 (GND), C5.2, C6.2, IC1.2 (SDX), IC1.3 (SCX), IC1.6 (GND), IC1.7 (GND), IC1.9 (INT2), IC2.4 (GND), J1.01, J1.04, J1.07, J1.10, J1.13, J1.16, J8.1, J8.8, J8.16, U1.1 (GND); also elsewhere on the board

Notes on the sheet:
Both capacitors used here should be ceramic. Place the capacitors as close to pin 8 as possible.
Jumpers
PWM/DSHOT Pins
H3LIS331DL IMU BREAKOUT
Additional Breakout Pins
LSM6DSR IMU
Arduino Nano ESP32
Radiomaster RP2

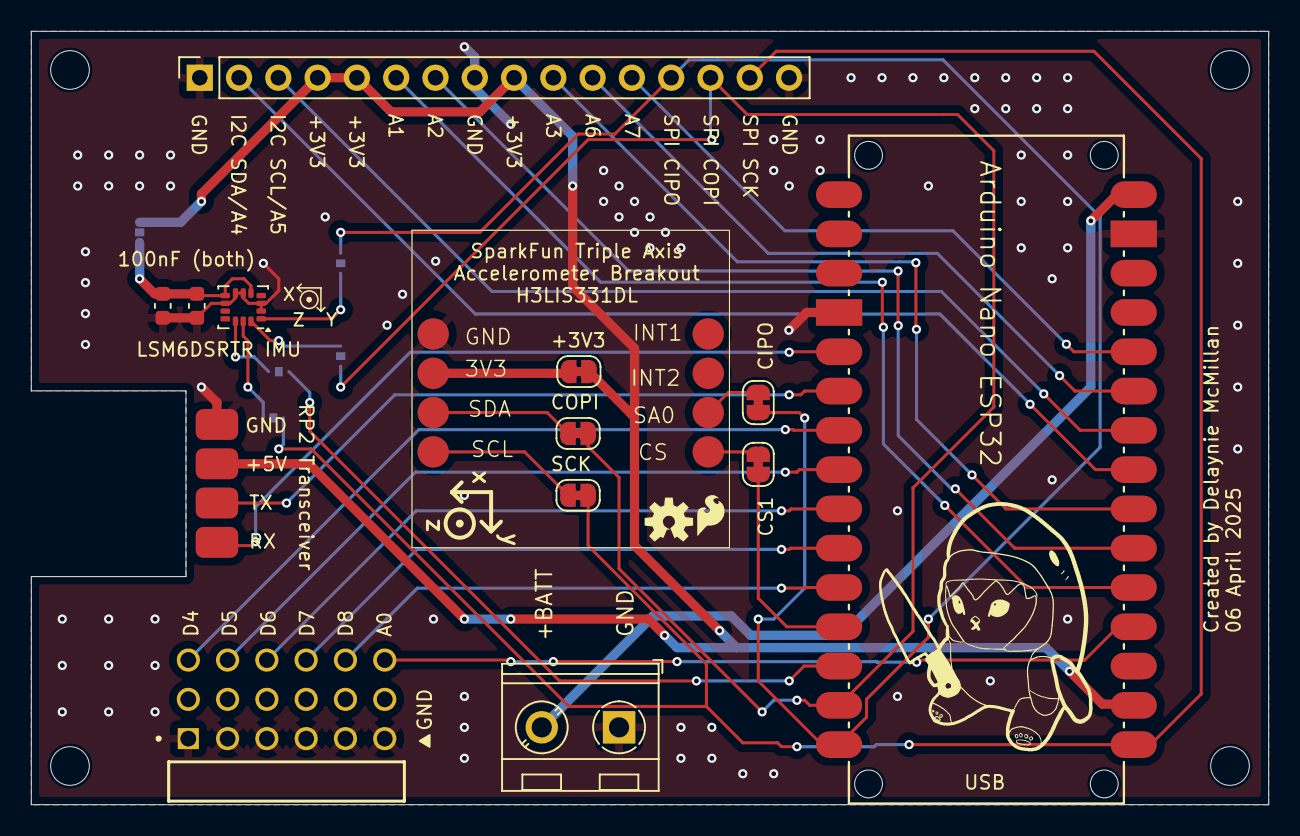
[picture p32: board openhell-pcb/combat-pcb.kicad_pcb from above]

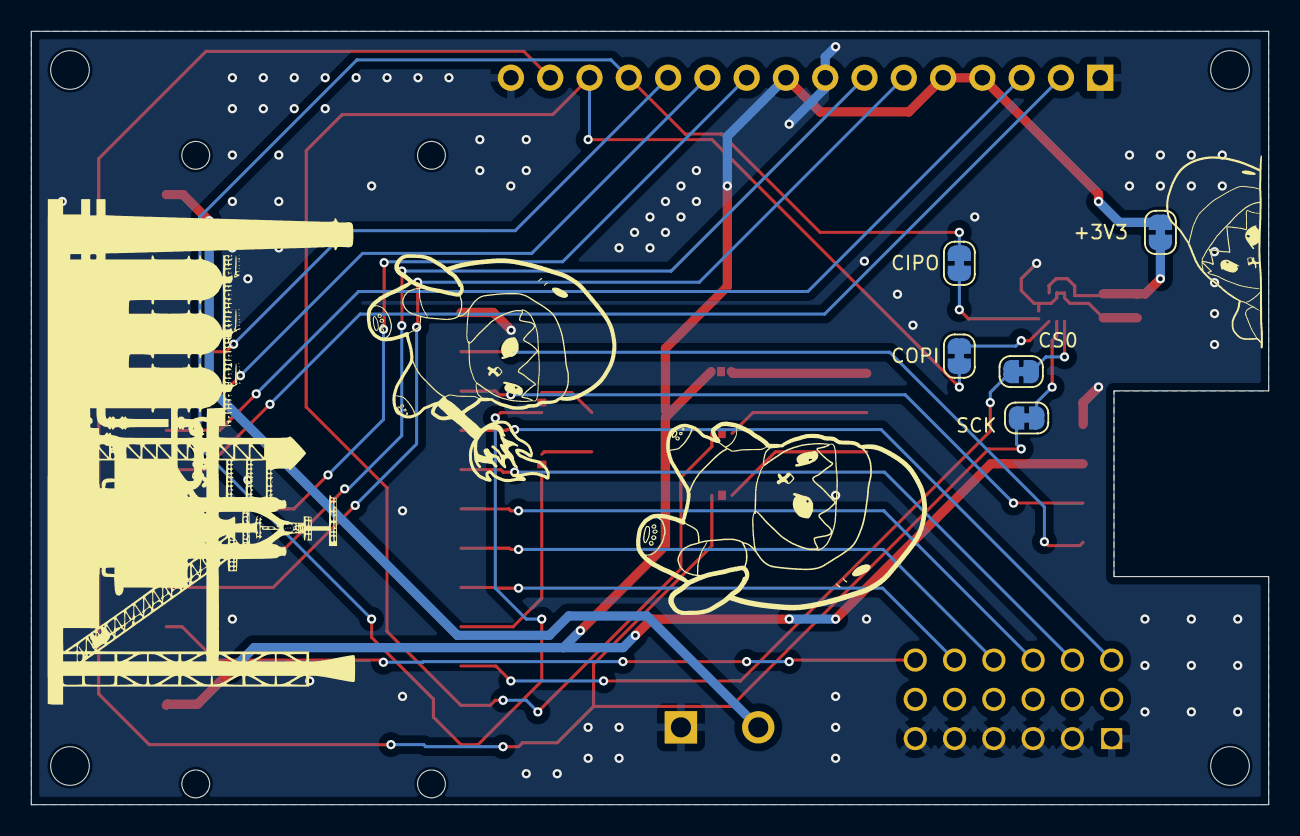
[picture p33: board openhell-pcb/combat-pcb.kicad_pcb from below]

Board: 2 copper layers, 80.0 x 50.0 mm, 19 parts (5 on the bottom side), 23 nets.

Other parts of the board:
J7: Screw_Terminal_01x02; TerminalBlock_RND_205-00045_1x02_P5.00mm_Horizontal

Their connections:
+BATT: J7.2; also elsewhere on the board
GND: J7.1; also elsewhere on the board
