mkhrenov/openhell/combat-pcb/combat-pcb.kicad_pcb

## KiCad design combat-pcb/combat-pcb.kicad_pcb (2025-04-08, an earlier design)

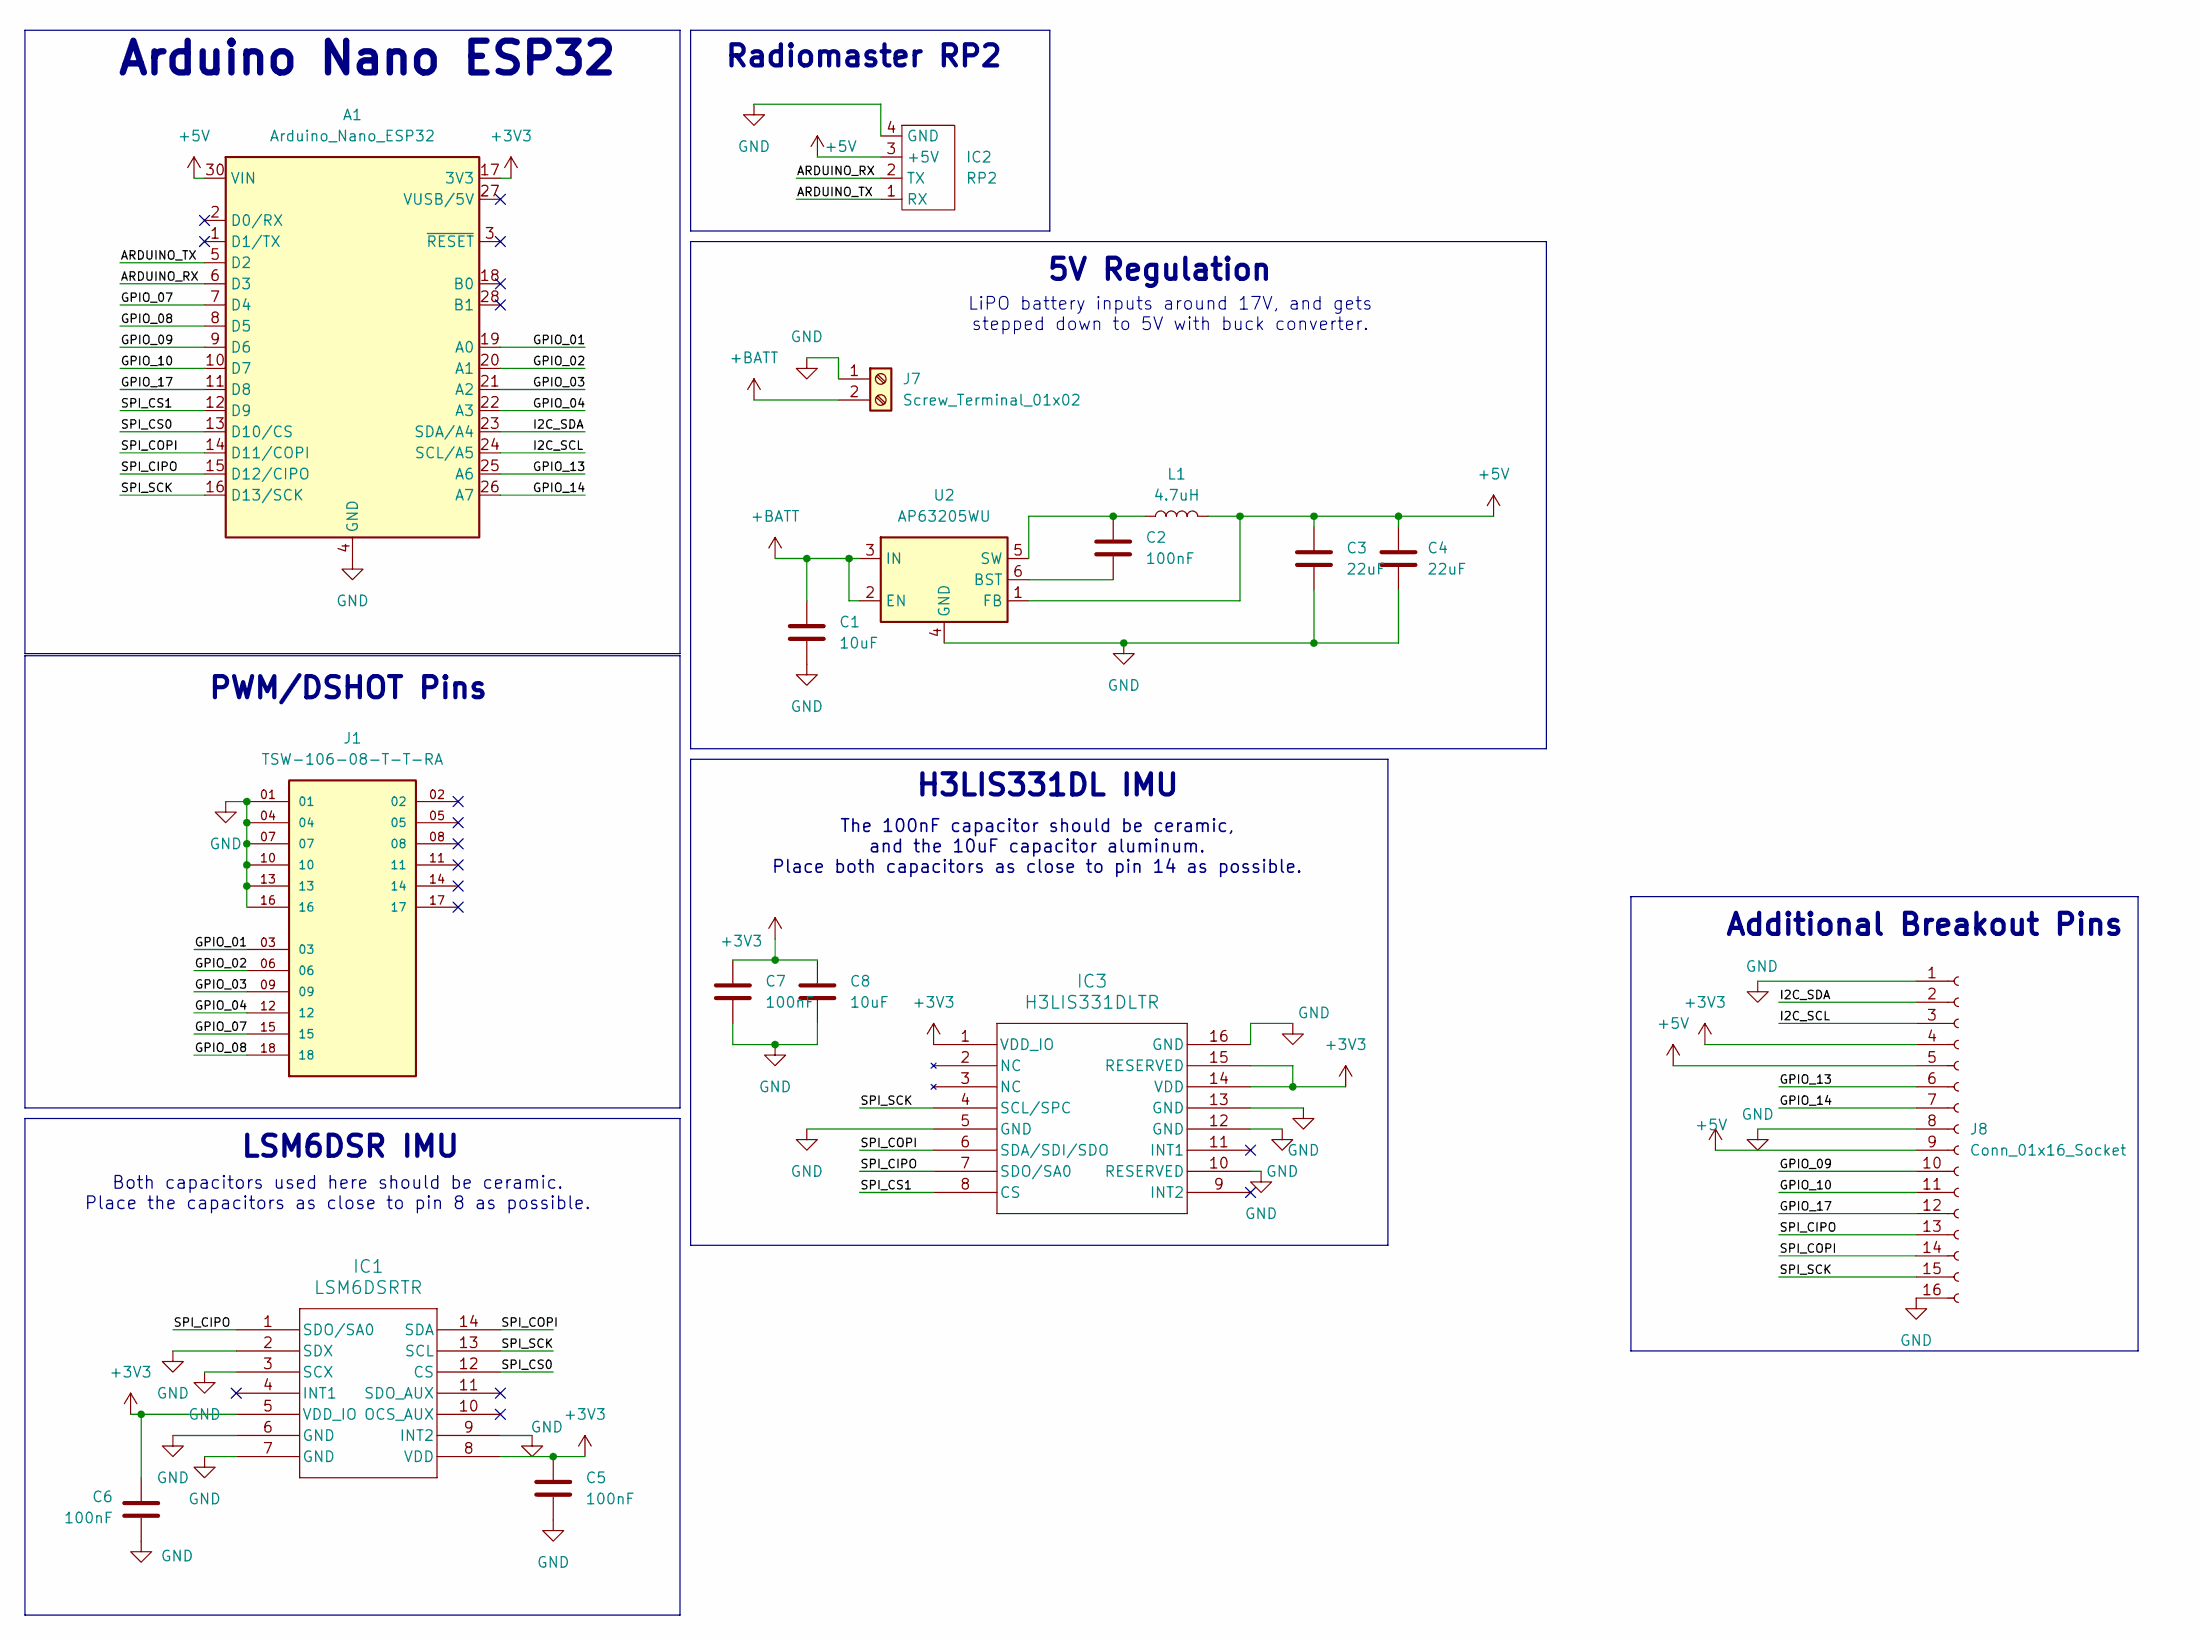
[picture p34: schematic combat-pcb.kicad_sch]

Parts:
A1: Arduino_Nano_ESP32; Arduino_Nano_ESP32_Tile
C1: 10uF; C_0603_1608Metric
C2: 100nF; C_0603_1608Metric
C3, C4: 22uF; C_0603_1608Metric
C5, C6, C7: 100nF; C_0402_1005Metric
C8: 10uF; C_0805_2012Metric
IC1: LSM6DSRTR; LGA-14L_2P5X3X0P83_STM
IC2: RP2
IC3: H3LIS331DLTR; QFN_31DLTR_STM
J1: TSW-106-08-T-T-RA; SAMTEC_TSW-106-08-T-T-RA; PARTREV R
J7: Screw_Terminal_01x02; TerminalBlock_RND_205-00045_1x02_P5.00mm_Horizontal
J8: Conn_01x16_Socket; PinSocket_1x16_P2.54mm_Vertical
L1: 4.7uH; IND_ASPI-4030S-4R7M-T
U2: AP63205WU; TSOT-23-6

Connections:
+3V3: A1.17 (3V3), C5.1, C6.1, C7.1, C8.1, IC1.5 (VDD_IO), IC1.8 (VDD), IC3.1 (VDD_IO), IC3.14 (VDD), IC3.15 (RESERVED), J8.4
+5V: A1.30 (VIN), C3.1, C4.1, IC2.3 (+5V), J8.5, J8.9, L1.2, U2.1 (FB)
+BATT: C1.1, J7.2, U2.2 (EN), U2.3 (IN)
/ARDUINO_RX: A1.6 (D3), IC2.2 (TX)
/ARDUINO_TX: A1.5 (D2), IC2.1 (RX)
/GPIO_01: A1.19 (A0), J1.03
/GPIO_02: A1.20 (A1), J1.06
/GPIO_03: A1.21 (A2), J1.09
/GPIO_04: A1.22 (A3), J1.12
/GPIO_07: A1.7 (D4), J1.15
/GPIO_08: A1.8 (D5), J1.18
/GPIO_09: A1.9 (D6), J8.10
/GPIO_10: A1.10 (D7), J8.11
/GPIO_13: A1.25 (A6), J8.6
/GPIO_14: A1.26 (A7), J8.7
/GPIO_17: A1.11 (D8), J8.12
/I2C_SCL: A1.24 (SCL/A5), J8.3
/I2C_SDA: A1.23 (SDA/A4), J8.2
/SPI_CIPO: A1.15 (D12/CIPO), IC1.1 (SDO/SA0), IC3.7 (SDO/SA0), J8.13
/SPI_COPI: A1.14 (D11/COPI), IC1.14 (SDA), IC3.6 (SDA/SDI/SDO), J8.14
/SPI_CS0: A1.13 (D10/CS), IC1.12 (CS)
/SPI_CS1: A1.12 (D9), IC3.8 (CS)
/SPI_SCK: A1.16 (D13/SCK), IC1.13 (SCL), IC3.4 (SCL/SPC), J8.15
GND: A1.4 (GND), A1.29 (GND), C1.2, C3.2, C4.2, C5.2, C6.2, C7.2, C8.2, IC1.2 (SDX), IC1.3 (SCX), IC1.6 (GND), IC1.7 (GND), IC1.9 (INT2), IC2.4 (GND), IC3.5 (GND), IC3.10 (RESERVED), IC3.12 (GND), IC3.13 (GND), IC3.16 (GND), J1.01, J1.04, J1.07, J1.10, J1.13, J1.16, J7.1, J8.1, J8.8, J8.16, U2.4 (GND)
unnamed: C2.2, U2.6 (BST)
unnamed: C2.1, L1.1, U2.5 (SW)

Notes on the sheet:
Both capacitors used here should be ceramic. Place the capacitors as close to pin 8 as possible.
PWM/DSHOT Pins
H3LIS331DL IMU
The 100nF capacitor should be ceramic, and the 10uF capacitor aluminum. Place both capacitors as close to pin 14 as possible.
LiPO battery inputs around 17V, and gets stepped down to 5V with buck converter.
Additional Breakout Pins
LSM6DSR IMU
Arduino Nano ESP32
5V Regulation
Radiomaster RP2

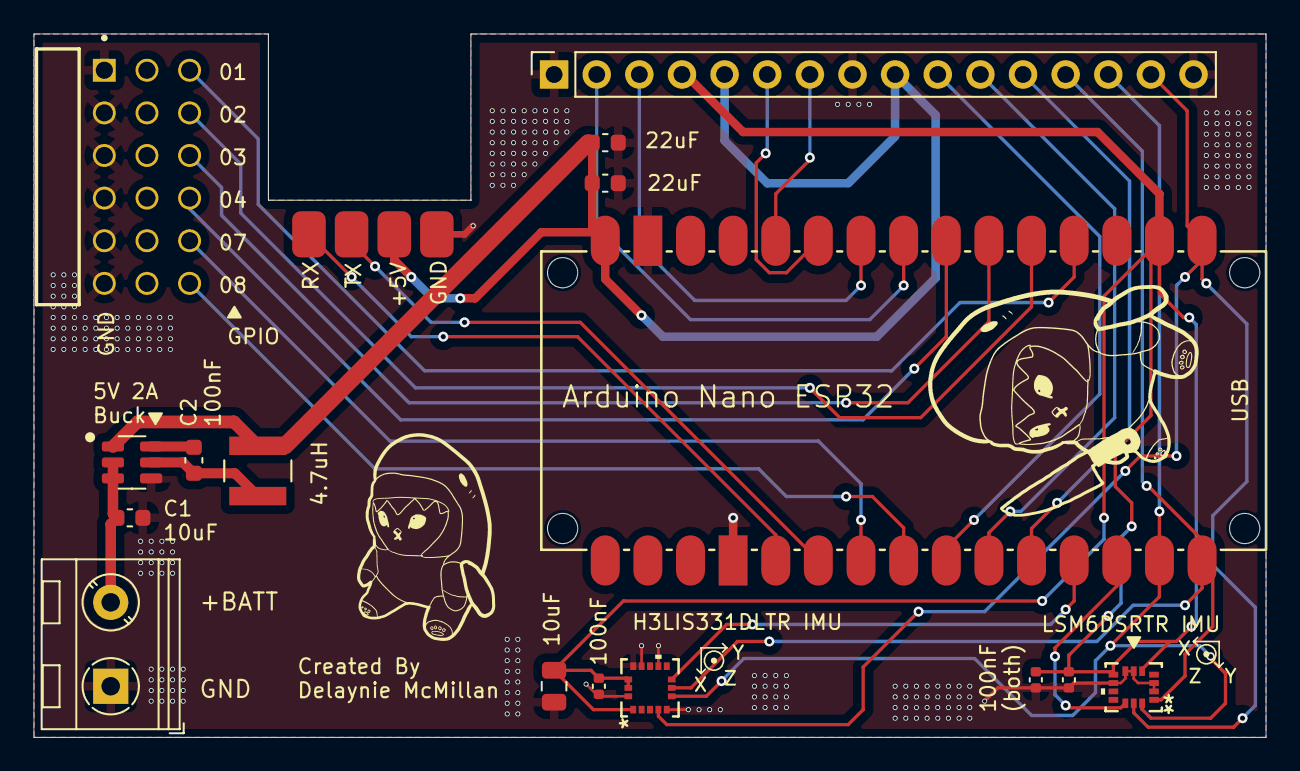
[picture p35: board combat-pcb/combat-pcb.kicad_pcb from above]

Board: 2 copper layers, 73.4 x 41.9 mm, 17 parts (0 on the bottom side), 26 nets.
