mkhrenov/openhell/firmware/include/InertialSensors.h

// #include <Adafruit_MPU6050.h>
#include <Adafruit_H3LIS331.h>
#include "LSM6DSR.h"

namespace imus {
    #define H3LIS331_CS 9
    #define LSM6DSR_CS 10
    #define IMU_UPDATE_PERIOD_US 1000

    void begin(void);
    void update(void);
    void calibrate(void);

    float low_accel_x(void);
    float low_accel_y(void);
    float low_accel_z(void);
    float gyro_x(void);
    float gyro_y(void);
    float gyro_z(void);
    float high_accel_x(void);
    float high_accel_y(void);
    float high_accel_z(void);

    float get_offset(void);
    void set_rescale_low(float rs);
    void set_rescale_high(float rs);
    void set_rescales_nv(void);

    float angular_velocity(void);

    void print(void);
}
