mkhrenov/openhell/(commit log)

2025-02-18 starting CAD
    [A-1000-N - PANCAKE.SLDASM, P-1001-M - PLATE.SLDPRT]
2025-03-02 Hat v1
    [A-0000-N - FRICK.SLDASM, A-1000-N - PANCAKE.SLDASM, A-2000-N - HAT.SLDASM, P-1005-F - MAIN STRUCTURE.SLDPRT, P-2001-F - MAIN HAT.SLDPRT]
2025-03-03 Added lift EDF
    [P-1006-P - 64mm EDF.SLDPRT]
2025-03-03 Updated EDF with 40mm config
    [P-1006-P - 64mm EDF.SLDPRT, P-1006-P - EDF.SLDPRT]
2025-03-04 reworking to hovermelt
    [A-0000-N - FRICK.SLDASM, A-1000-N - PANCAKE.SLDASM, P-1000-P - BRIM.SLDPRT, P-1000-P - HAT.SLDPRT, P-1001-M - PLATE.SLDPRT, P-1003-P - BLADE.SLDPRT, P-1004-P - M5 FLANGED LOCKNUT 92461A200.SLDPRT, P-1005-F - MAIN STRUCTURE.SLDPRT]
2025-03-04 fasteners and fans
    [A-1000-N - PANCAKE.SLDASM, P-1000-P - BRIM.SLDPRT, P-1000-P - HAT.SLDPRT, P-1000-P - M5 20mm BUTTON HEAD SCREW 91306A668.SLDPRT, P-1001-M - PLATE.SLDPRT, P-1003-P - BLADE.SLDPRT, P-4106-P - No. 6 0.375in TORX PLASTITE SCREW 99512A665.SLDPRT]
2025-03-04 reorganization to flatter hierarchy, removed unneeded parts
    [A-0000-N - FRICK.SLDASM, A-0000-N - HOVERMELT.SLDASM, A-1000-N - PANCAKE.SLDASM, A-1100-N - BEARING SHAFT.SLDASM, A-1200-N - STRUCTURAL SHAFT.SLDASM, A-2000-N - HAT.SLDASM, P-1000-P - BRIM.SLDPRT, P-1000-P - HAT.SLDPRT]
2025-03-08 brim, etc
    [A-0000-N - HOVERMELT.SLDASM, P-1001-M - PLATE.SLDPRT, P-1002-P - BLADE.SLDPRT, P-1003-P - BRIM.SLDPRT, P-1004-P - HAT.SLDPRT, P-1005-P - SPREADER.SLDPRT, P-3001-P - EDF.SLDPRT, P-3002-P - 4S 2000 mAh BATTERY.SLDPRT]
2025-03-08 Moved spreader file
    [P-1005-P - SPREADER.SLDPRT]
2025-03-09 Electronics, weight
    [A-0000-N - HOVERMELT.SLDASM, Body.SLDPRT, Body001.SLDPRT, Body004.SLDPRT, Body005.SLDPRT, P-1002-P - BLADE.SLDPRT, P-1003-P - BRIM.SLDPRT, P-1004-P - HAT.SLDPRT]
2025-03-10 added combat pcb files
    version 0, pre-design review
    [DigiKey-BOM.csv, Mouser-BOM.xls, OLD-combat-pcb.kicad_pcb, Screw_Terminal_01x02.stp, combat-pcb.kicad_pcb, combat-pcb.kicad_sch]
2025-03-12 placed JLCPCB order. these are the files I sent
    [Mouser-BOM.xls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]
2025-03-29 Updated EDFs and EDF mounting positions
    [A-0000-N - HOVERMELT.SLDASM, P-1001-M - PLATE.SLDPRT, P-1002-P - BLADE.SLDPRT, P-1003-P - BRIM.SLDPRT, P-1004-P - HAT.SLDPRT, P-1005-P - SPREADER.SLDPRT, P-3001-P - EDF.SLDPRT]
2025-03-29 Added mounting for diffuser
    [A-0000-N - HOVERMELT.SLDASM, P-1001-M - PLATE.SLDPRT, P-1004-P - HAT.SLDPRT, P-1005-P - SPREADER.SLDPRT]
2025-04-01 small updates to spreader and 3D prints
    [A-0000-N - HOVERMELT.SLDASM, P-1001-M - PLATE.DXF, P-1003-P - BRIM.STEP, P-1004-P - HAT.STEP, P-1005-P - SPREADER.SLDPRT, P-1005-P - SPREADER.STEP]
2025-04-04 Updating hat to improve fitment
    [A-0000-N - HOVERMELT.SLDASM, P-1001-M - PLATE.SLDPRT, P-1002-P - BLADE.SLDPRT, P-1004-P - HAT V2.SLDPRT, P-1004-P - HAT V2.STEP, P-1004-P - HAT.SLDPRT, P-1005-P - SPREADER.SLDPRT]
2025-04-04 Updated Hat with Protoboard Geometry
    [P-1004-P - HAT V2.SLDPRT, P-3005-P - PROTOBOARD.SLDPRT]
2025-04-08 V2 of OPENHELL
    [P-1004-P - HAT V2.SLDPRT]
2025-04-08 added LED channel
    [P-1004-P - HAT V2.SLDPRT]
2025-04-08 Sensors work, CRSF works
2025-04-08 Load cell and blade files
    [D-1002-P - BLADE.DXF, EDF LOAD CELL MOUNT.3MF, EDF LOAD CELL MOUNT.SLDPRT]
2025-04-11 EDF characterization
    [300-15.80.csv, 400-15.90.csv, 500-15.80.csv, 600-16.65.csv, 700-16.50.csv, 800-16.35.csv, 900-16.20.csv, 999-16.05.csv]
2025-04-11 Updated to 2nd order model
    [chirp.tsv]
2025-04-12 Updated thrust constant, fixed RMT channel re-use conflict with LEDs and motors, temporarily disabled PI controller for angular rate
    [Fans.cpp, Fans.h, main.cpp]
2025-04-13 Electrical analysis + weapon 'locks'
    [P-1001-M - PLATE.SLDPRT, P-1002-P - BLADE.SLDPRT, P-1003-P - BRIM.SLDPRT, P-1004-F - SIDE WEAPON LOCK.SLDPRT, P-1004-P - HAT V2.SLDPRT, P-1005-F - TOP WEAPON LOCK.SLDPRT, P-1005-P - SPREADER.SLDPRT, S-1004-F - SIDE WEAPON LOCK.3MF]
2025-04-13 Added gap in center weapon lock
    [A-0000-N - HOVERMELT.SLDASM, P-1004-P - HAT.SLDPRT, P-1005-F - TOP WEAPON LOCK.SLDPRT, S-1005-F - TOP WEAPON LOCK.3MF]
2025-04-14 Updated hat w/ more electronics space
    [P-1004-P - HAT V2.SLDPRT, P-1004-P - HAT V2.STEP]
2025-04-19 Moved over to LSM6DSR for low-g IMU, own drivers
2025-04-19 Fixed angular velocity axis definition, added RPM telemetry
    [Receiver.cpp, Receiver.h, main.cpp]
2025-04-19 Comments to remember which GPIO pins correspond to which Arduino pin numbers
2025-04-20 Added linear ramp on thrust cyclic amplitude rather than cutting to 0 (hopefully to deal with voltage spike events)
2025-04-20 Fusing two imus, linear fade-in
2025-04-21 Hovermelting works, added bias calibration, and currently use volatile "rescale" variable to calibrate low-g imu, high-g imu temporarily disabled, need non-volatile storage and better calibration.
2025-04-28 Added non-volatile storage for gyro scale factors, re-ordered input channels, rescaled
2025-04-29 New weapon lock + service cap + deeper plastite holes
    [A-0000-N - HOVERMELT V2.SLDASM, P-1004-P - HAT V2.SLDPRT, P-1004-P - HAT V2.STEP, P-1005-F - TOP WEAPON LOCK V2.SLDPRT, P-1006-F - SERVICE CAP.SLDPRT, P-1006-F - SERVICE CAP.STEP]
2025-05-05 pcb updated to design used in May 2025 comp
    do note that the pcb file here includes the 5V power line connection
    that was missing on the actual pcb that got used.
    renamed combat-pcb to openhell-pcb.
    [DigiKey-BOM.csv, Mouser-BOM.xls, OLD-combat-pcb.kicad_pcb, Pinout.xlsx, Screw_Terminal_01x02.stp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]
